eSpark-Backup/manarharake-palmpcb/Design_Files/Renderings/3D_Isometric.PNG

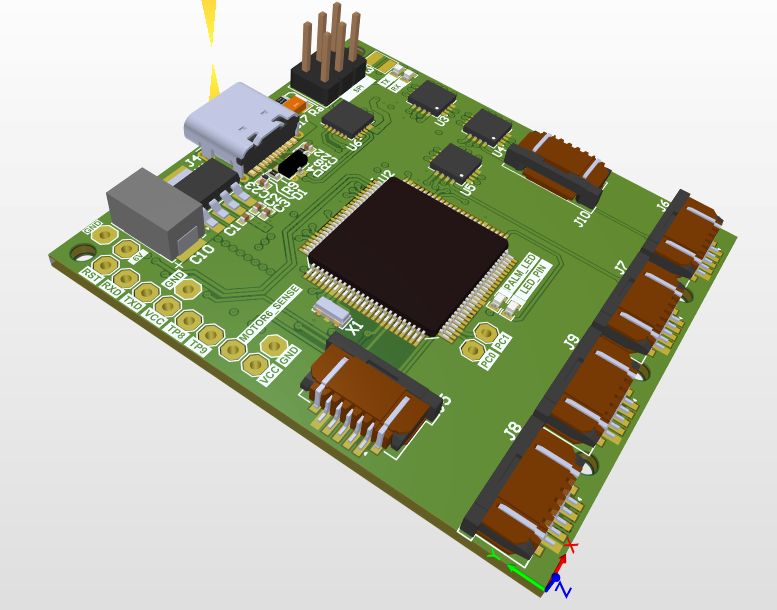
Design_Files/Renderings/3D_Isometric.PNG
