eSpark-Backup/manarharake-palmpcb/Design_Files/Renderings/3D_Top.PNG

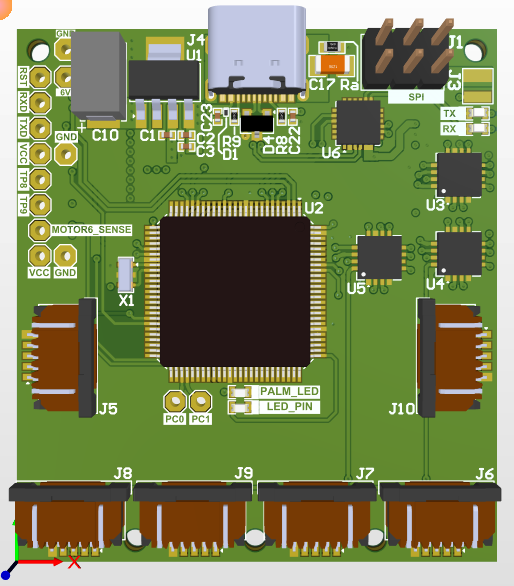
Design_Files/Renderings/3D_Top.PNG
