eSpark-Backup/manarharake-palmpcb/Design_Files/Renderings/2D_Bottom_Layer.PNG

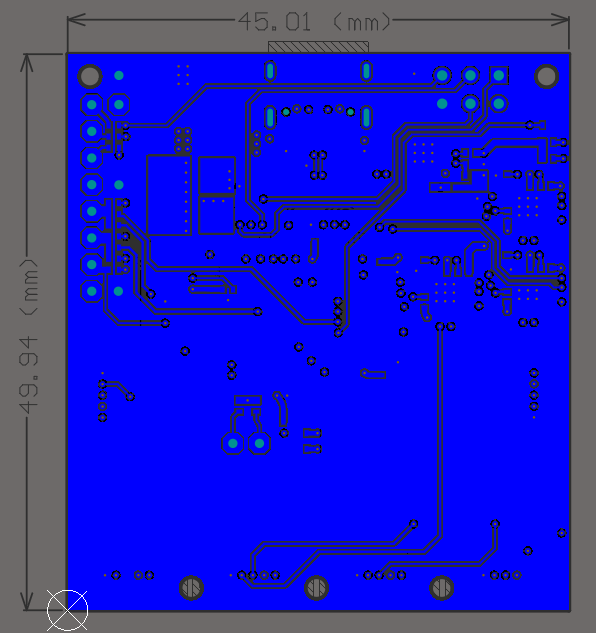
Design_Files/Renderings/2D_Bottom_Layer.PNG
