eSpark-Backup/manarharake-palmpcb/Design_Files/Renderings/2D_Signal_1_Layer.PNG

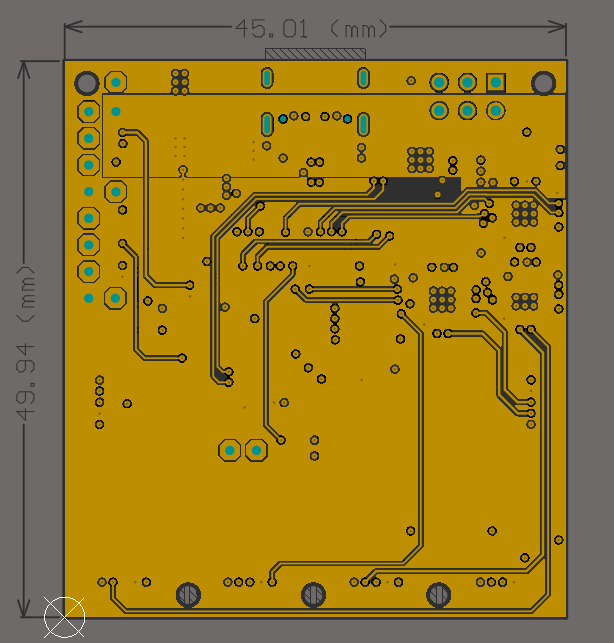
Design_Files/Renderings/2D_Signal_1_Layer.PNG
