eSpark-Backup/manarharake-palmpcb/Design_Files/Renderings/2D_Signal_2_Layer.PNG

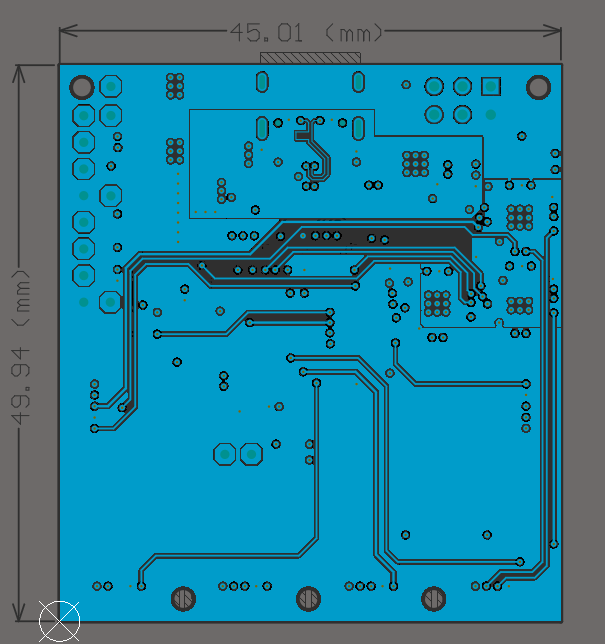
Design_Files/Renderings/2D_Signal_2_Layer.PNG
