eSpark-Backup/manarharake-palmpcb/Design_Files/Renderings/2D_Top.PNG

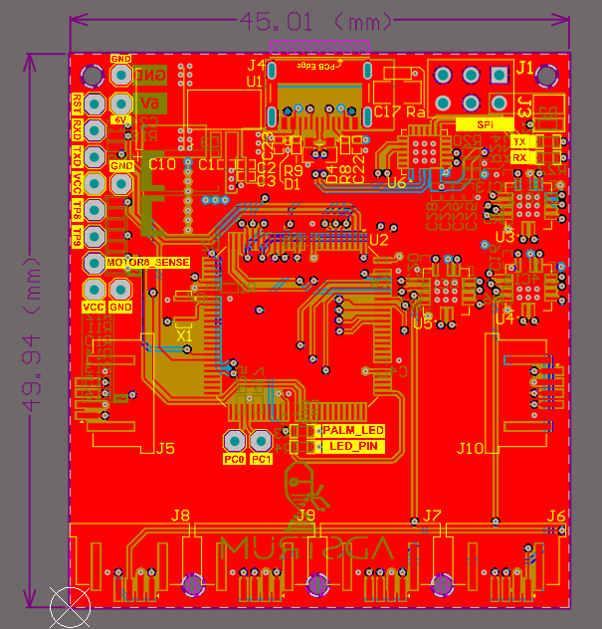
Design_Files/Renderings/2D_Top.PNG
