eSpark-Backup/manarharake-palmpcb/Design_Files/Renderings/3D_Bottom.PNG

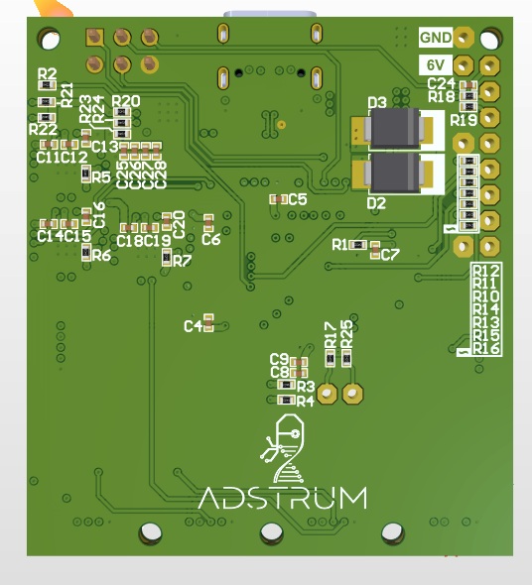
Design_Files/Renderings/3D_Bottom.PNG
