eSpark-Backup/manarharake-palmpcb/docs/Client-Files/palm1/PCB2/PCB files/Bottom.png

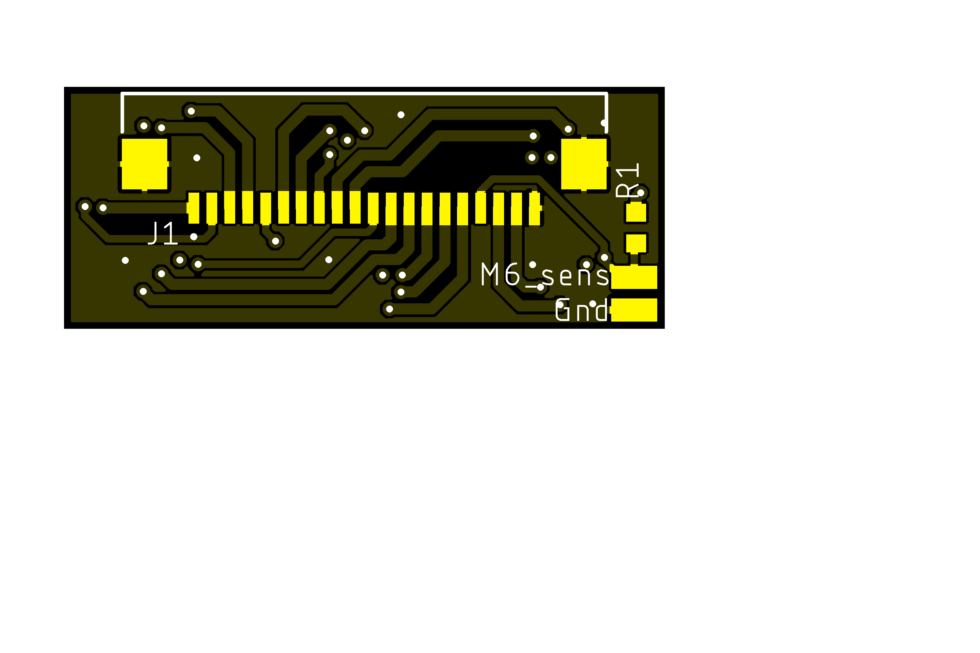
docs/Client-Files/palm1/PCB2/PCB files/Bottom.png
