eSpark-Backup/manarharake-palmpcb/docs/Client-Files/palm1/PCB 1/PCB files/BOTTOM.png

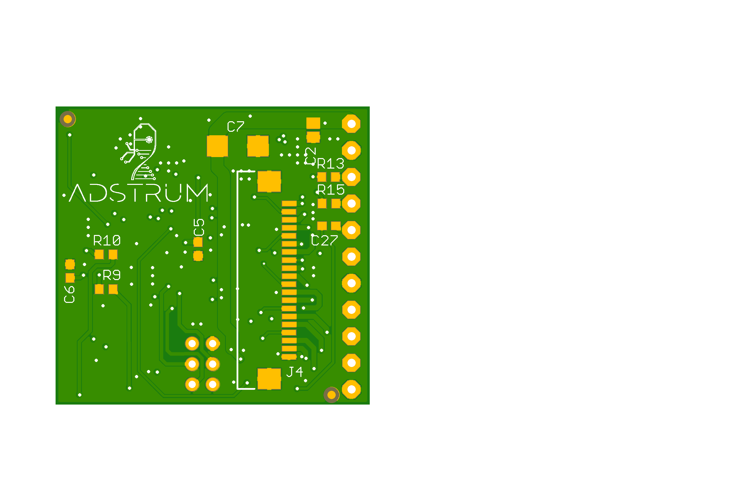
docs/Client-Files/palm1/PCB 1/PCB files/BOTTOM.png
