eSpark-Backup/manarharake-palmpcb/Design_Files/BOM/Client_BOM.xlsx

# | Item Type | Designator | Description | Footprint | Manufacturer Part Number | Manufacturer | Value | Quantity | Remarks
1 | Capacitor | C1, C3 | CAP CER 1UF 10V X5R 0402 | Cap-0402 | CC0402KRX5R6BB105 | Yageo | 1uF | 2
2 | Capacitor | C2 | CAP CER 10UF 10V X5R 0402 | Cap-0402 | CC0402MRX5R6BB106 | Yageo | 10uF | 1
3 | Capacitor | C4, C5, C6, C7, C8, C9, C12, C15, C19, C24, C25, C27 | CAP CER 0.1UF 25V X5R 0402 | Cap-0402 | CC0402KRX5R8BB104 | Yageo | 100nF | 12
4 | Capacitor | C10 | 47uF 25V 0.9Ω@100kHz ±10% CASE-D-7343 Tantalum Capacitors ROHS | Case-D | CA45-D025K476T | Hunan Xiangyee in S&T | 47uF | 1
5 | Capacitor | C11, C14, C18 | CAP CER 10000PF 50V X7R 0402 | Cap-0402 | CC0402KRX7R9BB103 | Yageo | 10nF | 3
6 | Capacitor | C13, C16, C20 | CAP CER 2.2UF 25V X5R 0402 | Cap-0402 | GRM155R61E225KE11D | Murata | 2.2uf | 3
7 | Capacitor | C17 | CAP CER 4700PF 1KV X7R 1206 | Cap-1206 | CC1206KKX7RCBB472 | Yageo | 4.7nF | 1
8 | Capacitor | C22, C23 | CAP CER 10000PF 25V X7R 0402 | Cap-0402 | CC0402KRX7R8BB103 | Yageo | 10nF | 2
9 | Capacitor | C26, C28 | CAP CER 4.7UF 10V X5R 0402 | Cap-0402 | CC0402KRX5R6BB475 | Yageo | 4.7uF | 2
10 | Diode | D1 | TVS DIODE 5VWM 6.3VC DSN0603-2 | DSN0603-2 | PESD5V0H1BSFYL | Nexperia | - | 1
11 | Diode | D2, D3 | 40V 5A 550mV@5A DO-214AA(SMB) Schottky Barrier Diodes (SBD) ROHS | SMB | SS54B-HF | Comchip (https://www.lcsc.com/brand-detail/11578.html) | - | 2
12 | Diode | D4 | 16A 20V 7V 5V@Max Unidirectional SOT-23 TVS ROHS | Sot-23 | ESD5302F-3/TR | WILLSEMI | - | 1
13 | Male Header | J1 | 3A Straight Square Pins 2.5mm 6P 6mm -40℃~+105℃ 3mm 2.54mm 双排 Black 2x3P 2.54mm Plugin,P=2.54mm Pin Headers ROHS | Custom | PH-01291 | Liansheng | - | 1
14 | SMD PAD | J3 | 2mm pitch Solder Pad | Custom | - | - | - | 1
15 | USB C Connector | J4 | 5A 1 16P Female Type-C SMD USB Connectors ROHS | Custom | TYPE-C-31-M-12 | Korean Hroparts Elec | - | 1
16 | FPC Connector | J5, J6, J7, J8, J9, J10 | CONN FFC FPC BOTTOM 5POS 1MM R/A | Custom | SFW5R-1STE1LF | Amphenol ICC / FCI (https://www.lcsc.com/brand-detail/86.html) | - | 6
17 | LED | LED1, LED2 | blue 0603 Light Emitting Diodes (LED) ROHS | LED-0603 | NCD0603B3 | Foshan NationStar Optoelectronics | - | 2
18 | LED | LED3, LED4 | yellow 0603 Light Emitting Diodes (LED) ROHS | LED-0603 | NCD0603Y2 | Foshan NationStar Optoelectronics | - | 2
19 | Resistor | R1, R5, R6, R7, R11, R13, R16 | RES 10K OHM 1% 1/16W 0402 | Res-0402 | RC0402FR-0710KL | Yageo | 10K | 7
20 | Resistor | R2 | RES 3.3K OHM 1% 1/16W 0402 | Res-0402 | RC0402FR-073K3L | Yageo | 3.3K | 1
21 | Resistor | R3, R4, R18, R19 | RES 1K OHM 5% 1/16W 0402 | Res-0402 | RC0402JR-071KL | Yageo | 1K | 4
22 | Resistor | R8, R9 | RES 5.1K OHM 1% 1/16W 0402 | Res-0402 | RC0402FR-075K1L | Yageo | 5.1K | 2
23 | Resistor | R10, R15 | RES 10K OHM 1% 1/16W 0402 | Res-0402 | RC0402FR-0710KL | Yageo | DNF | 2
24 | Resistors | R12, R14 | RES 0 OHM JUMPER 1/16W 0402 | Res-0402 | RC0402FR-070RL | Yageo | 0R | 2
25 | Resistor | R20 | RES 1.2K OHM 1% 1/16W 0402 | Res-0402 | RC0402FR-071K2L | Yageo | 1.2K | 1
26 | Resistor | R21, R22 | RES 470 OHM 1% 1/16W 0402 | Res-0402 | RC0402FR-07470RL | Yageo | 470R | 2
27 | Resistor | R23 | RES SMD 22.1KOHM 0.1% 1/16W 0402 | Res-0402 | RT0402BRD0722K1L | Yageo | 22.1K | 1
28 | Resistor | R24 | 62.5mW Thick Film Resistors 50V ±100ppm/℃ ±1% 47.5kΩ 0402 Chip Resistor - Surface Mount ROHS | Res-0402 | 0402WGF4752TCE | Uniroyal | 47.5K | 1
29 | Resistor | Ra | RES SMD 1M OHM 1% 1/10W 0603 | Res-0603 | RC0603FR-071ML | Yageo | 1M | 1
30 | IC | U1 | IC REG LINEAR 5V 1A SOT223-5 | SOT-223-5 | LP38692MP-5.0/NOPB | Texas Instruments | - | 1
31 | IC | U2 | IC MCU 8BIT 256KB FLASH 100TQFP | TQFP-100(14x14) | ATMEGA2560-16AU | Microchip | - | 1
32 | IC | U3, U4, U5 | IC MOTOR DRIVER PAR 16QFN | QFN-16-EP(4x4) | DRV8833RTYR | Texas Instruments | - | 3
33 | IC | U6 | IC USB TO UART BRIDGE QFN24 | 24-QFN (4x4) | CP2102N-A02-GQFN24R | Silicon Labs | - | 1
34 | Crystal | X1 | CERAMIC RES 16.0000MHZ 15PF SMD | SMD3213-3P | CSTNE16M0VH3C000R0 | Murata | - | 1
