eSpark-Backup/manarharake-palmpcb/docs/Client-Files/palm1/PCB 1/Manufacturing Files/BOM.xlsx

Starfish PCB BOM |  | Created By: Dharmik Patel https://www.upwork.com/o/profiles/users/~01178b3bf7c1a90506/
Qty | Value | Part no | Make | Package | Parts | Description
1 | 100nF - 50V | CC1210KKX7R9BB104 | Yageo | C1210 | C1 | CAPACITOR
9 | 100nF - 50V | CC0603KRX7R9BB104 | Yageo | C0603 | C3, C5, C6, C8, C10, C14, C17, C20, C27 | CAPACITOR
3 | 10nF - 50V | CL10B103KB8WPJC | Samsung Electro-Mechanics | C0603 | C16, C19, C22 | CAPACITOR
1 | 10uF | GRM21BR61H106KE43L | Murata Electronics | C0805 | C2 | CAPACITOR
2 | 1uF | CC0805KKX7R9BB105 | Yageo | C0805 | C4, C9 | CAPACITOR
3 | 2.2uF | GRM188R61H225KE11D | Murata Electronics | C0603 | C15, C18, C21 | CAPACITOR
1 | 47u/16V Tantlum | TAJC476K016RNJ (https://www.digikey.in/en/products/detail/kyocera-avx/TAJC476K016RNJ/563823) | AVX | C/6032-28R | C7 | POLARIZED CAPACITOR
4 | 1K | RC0603FR-071KL | Yageo | R0603 | R13, R14, R15, R17 | RESISTOR
1 | 3k3 | M55342K12B3E30MTSV-ND |  | R0603 | R1 | RESISTOR
2 | DNF | R-EU_R0603 |  | R0603 | R9, R10 | RESISTOR
2 | 0R | R-EU_R0603 |  | R0603 | R8, R12 | RESISTOR
6 | 10K | RC0603FR-0710KL | Yageo | R0603 | R3, R4, R5, R6, R7, R11 | RESISTOR
1 | ATMEGA2560-16AU | ATMEGA2560-16AU |  | TQFP100 | IC1 | MICROCONTROLLER
1 | CSTNE16M0VH3C000R0 | CSTNE16M0VH3C000R0 (https://www.digikey.in/en/products/detail/murata-electronics/CSTNE16M0VH3C000R0/8747732) |  | OSC_CSTNE16M0VH3C000R0 | Y1 | 16MHz Ceramic Resonator Built in Capacitor 15pF Â±0.15% 40 Ohms
1 | DNF | AVRISP-6 |  | AVRISP | J3 | AVR ISP HEADER
3 | DRV8833RTYT | DRV8833RTYT |  | QFN65P400X400X80-17N | U2, U3, U4 | DUAL H-BRIDGE MOTOR DRIVER,QFN-16
1 | FFC3B07-20-T | FFC3B07-20-T (https://www.digikey.in/en/products/detail/gct/FFC3B07-20-T/10657038) |  | GCT_FFC3B07-20-T | J4 | FPC 1.0mm Pitch, Side entry, Top contact, SMT, Height 2.5mm, Slide type
1 | LP38692MP-5.0 | LP38692MP-5.0 (https://www.digikey.in/en/products/detail/texas-instruments/LP38692MP-5-0-NOPB/723329) |  | SOT150P696X180-5N | U7 | Linear Regulator Check availability
