eSpark-Backup/manarharake-palmpcb/docs/Client-Files/palm1/PCB2/Manufacturing File/BOM.xlsx

Starfish PCB2 BOM |  | Created By: Dharmik Patel https://www.upwork.com/o/profiles/users/~01178b3bf7c1a90506/
Qty | Value | Part no | Make | Package | Parts | Description
1 | 10K | RC0603FR-0710KL | Yageo | R0603 | R1 | RESISTOR, European symbol
1 | FFC3B07-20-T | FFC3B07-20-T (https://gct.co/connector/ffc3b07) | GCT | SMD | J1 | FPC 1.0mm Pitch, Side entry, Top contact, SMT, Height 2.5mm, Slide type
6 | SFW5R-1STE1LF | SFW5R-1STE1LF | FCI_SFW5R-1STE1LF | SMD | M1, M2, M3, M4, M5, M6 | FFC/FPC CONNECTOR, RECEPTACLE, 5POS 1ROW
