eSpark-Backup/manarharake-palmpcb/Design_Files/Supporting Files/PCB_Palm_v2.0.step

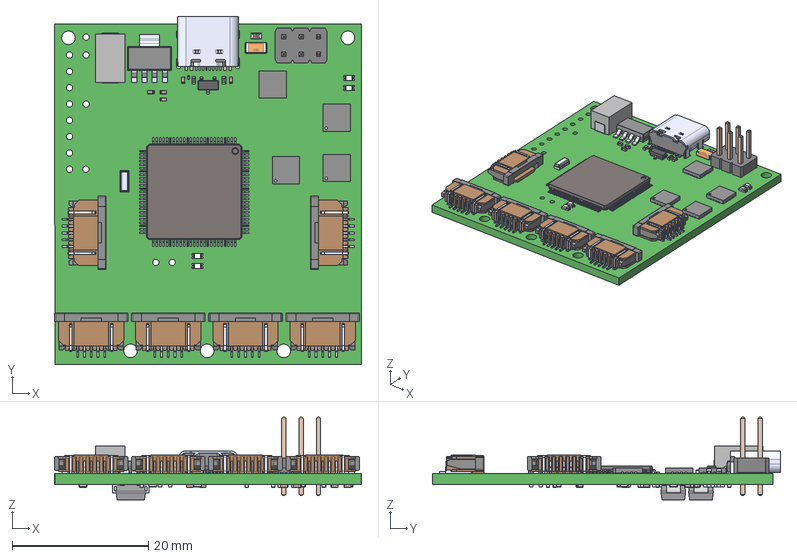
[picture p13: CAD file, 2024-06-21]
Design_Files/Supporting Files/PCB_Palm_v2.0.step
45.1 x 51.1 x 12.2 mm
User_Library-RES_1005-0402 x 25
User_Library-Capacitor_0402 x 25
SFW8R-1STE1LF_SFW5R-1STE1LF x 6
TYPE-C-31-M-12
User_Library-LED_SMD0603 x 4
CP2102N-A02-GQFN24R--3DModel-STEP-56544
CircuitWorks-SOT-23
User_Library-DO-214AA_SMB x 2
CSTCE16M0V53-R0
DRV8833RTYR x 3
TQFP_100
LP38692MP-5.0
User_Library-RESC1608X05N
6130xx21121_PIN x 6
PESD5V0H1BSF
User_Library-1206_SMD_Capacitor
