eSpark-Backup/manarharake-palmpcb/docs/Client-Files/palm1/PCB2/3D file/Motor Connection V1.stp

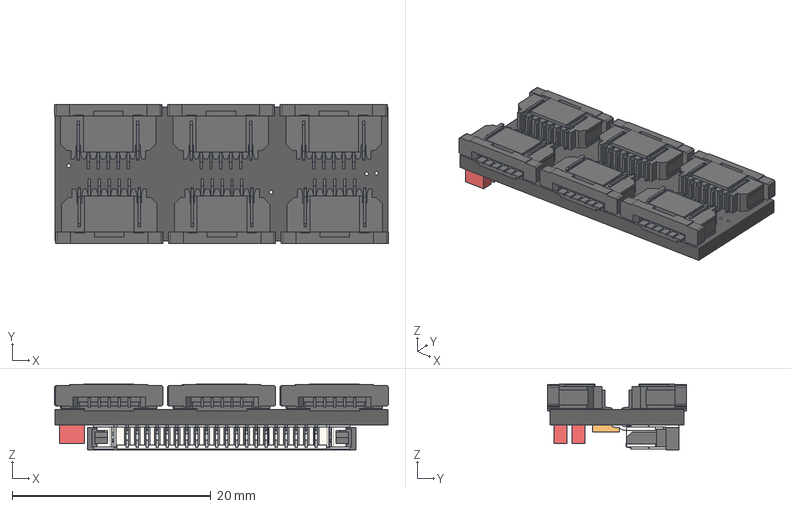
[picture p14: CAD file, 2024-06-12]
docs/Client-Files/palm1/PCB2/3D file/Motor Connection V1.stp
33.6 x 14.0 x 6.62 mm
Board
SFW5R-1STE1LF x 6
_FFC3B07-20_H1
_FFC3B07-20_H2
_FFC3B07_SC x 2
_FFC3B07-T_P x 20
R0603
SMD1,27-2,54 x 2
