eSpark-Backup/manarharake-palmpcb/docs/Client-Files/pcb-reference-files/PCB Layout Top.DXF

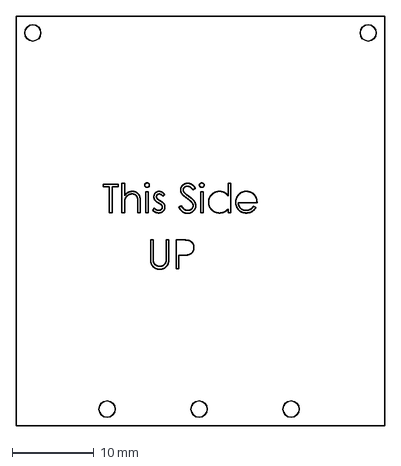
[picture p15: CAD file, 2024-06-20]
docs/Client-Files/pcb-reference-files/PCB Layout Top.DXF
45.0 x 50.0 mm
