eSpark-Backup/manarharake-palmpcb/docs/Client-Files/pcb-reference-files/PCB Layout Bottom.DXF

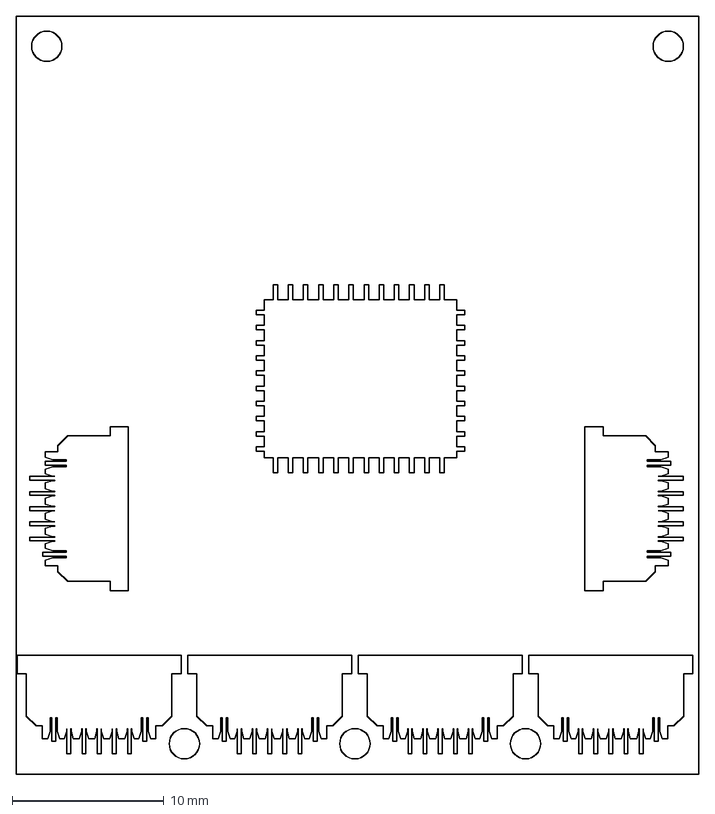
[picture p16: CAD file, 2024-06-20]
docs/Client-Files/pcb-reference-files/PCB Layout Bottom.DXF
45.0 x 50.0 mm
