eSpark-Backup/manarharake-palmpcb/docs/Client-Files/pcb-reference-files/starfish-PCB1.stp

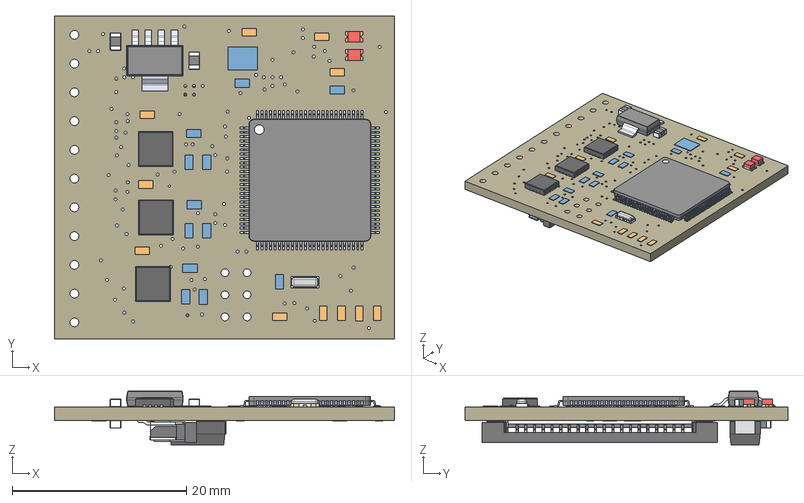
[picture p17: CAD file, 2024-06-12]
docs/Client-Files/pcb-reference-files/starfish-PCB1.stp
39.0 x 37.0 x 6.14 mm
Board
3k3 x 15
100nF
100nF_1 x 15
DRV8833RTYT
DRV8833RTYT_1
DRV8833RTYT_2
ATMEGA2560-16AU
LP38692MP-5.0
Gehäuse x 3
Kontaktfläche x 6
47u/16V Tantlum
_FFC3B07-20_H1
_FFC3B07-20_H2
_FFC3B07_SC x 2
_FFC3B07-T_P x 20
CHIPLED_0805
CHIPLED_0805 (1)
BASE
PIN2
PIN1 AND PIN3 x 2
HAT
gnd x 2
