eSpark-Backup/manarharake-palmpcb/(list of files, cad)

Other CAD files:
Design_Files/Supporting Files/PCB_Palm_v2.0.DWG
Design_Files/Supporting Files/PCB_Palm_v2.0.DXF
