eSpark-Backup/manarharake-palmpcb/Design_Files/Schematics/Schematic_Palm_V2.0.pdf

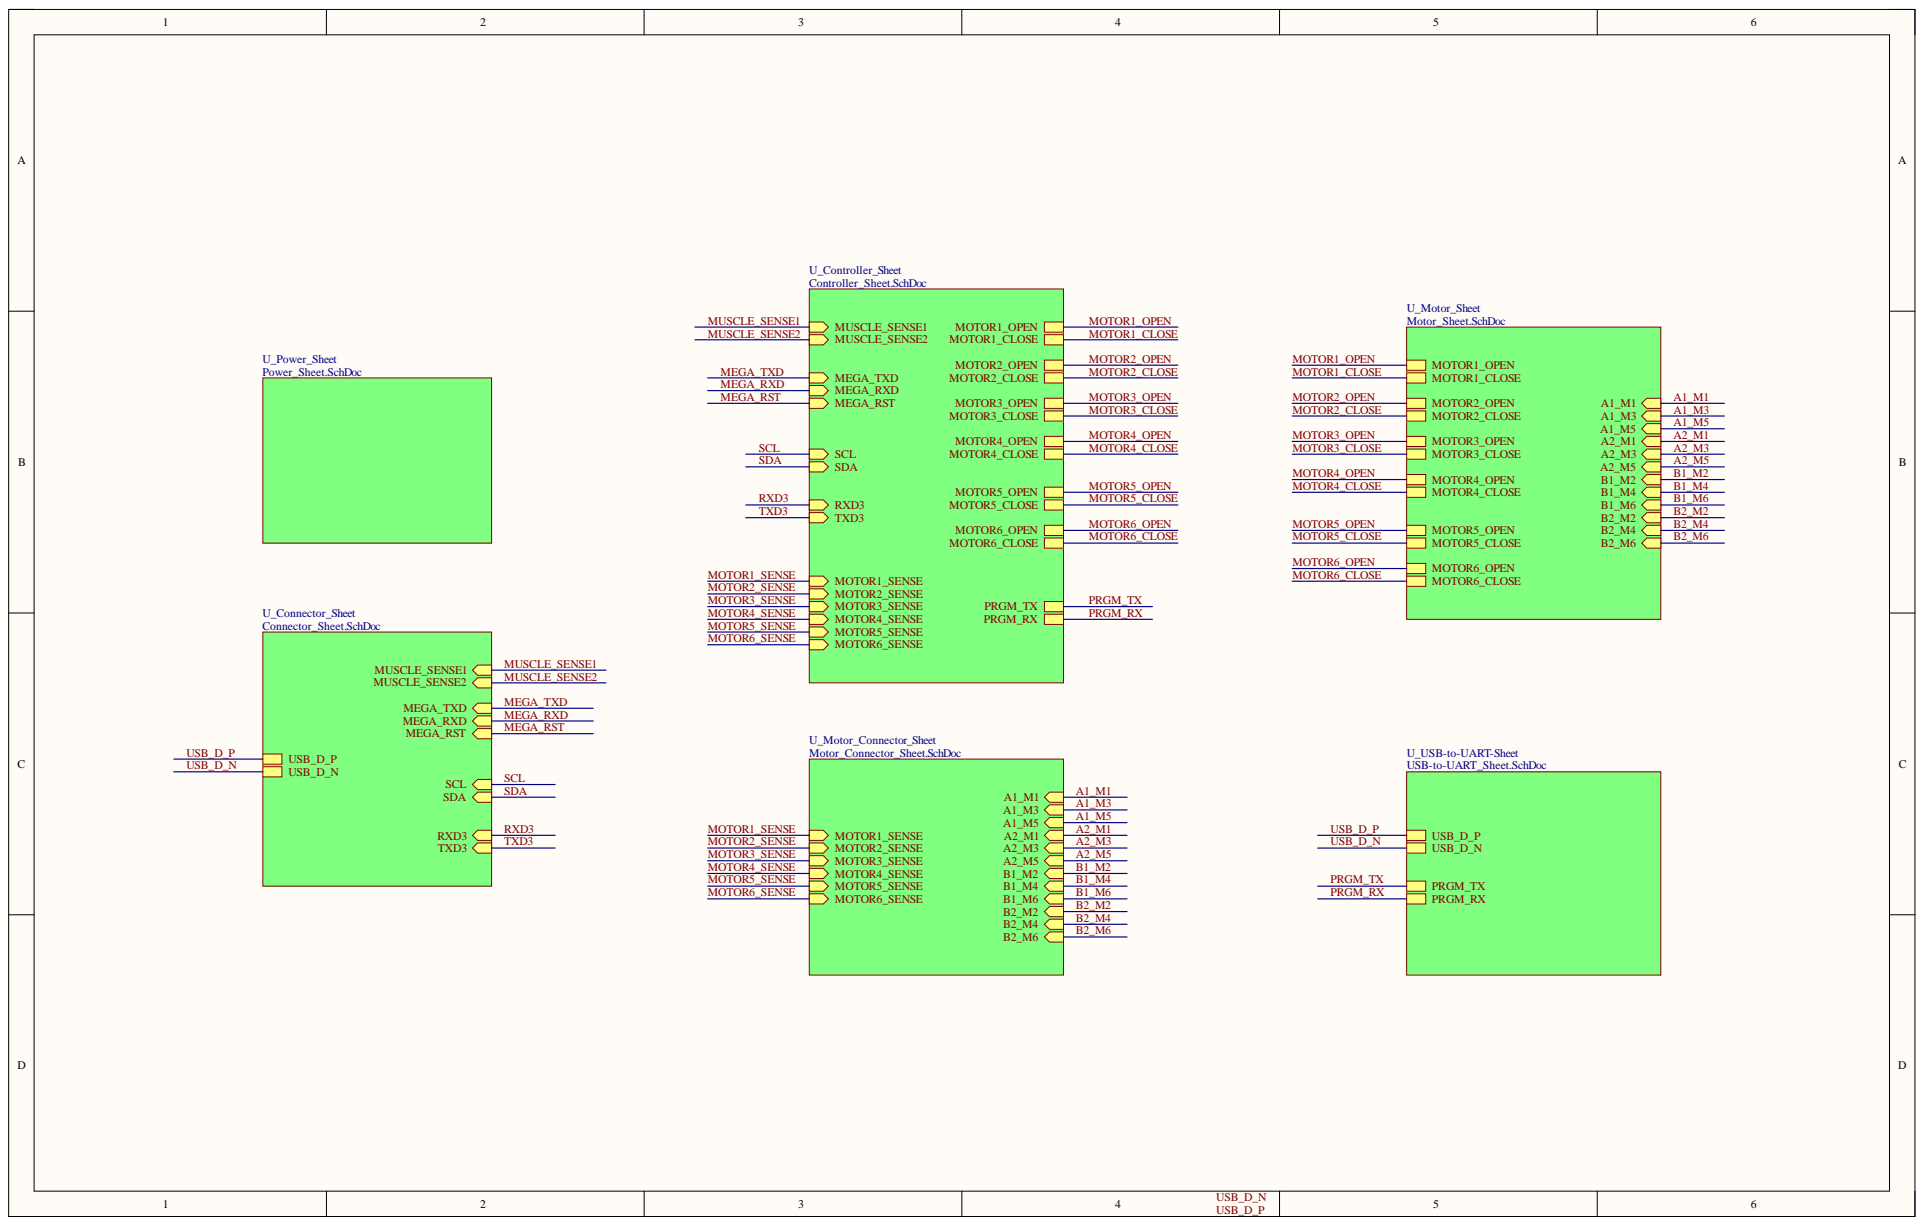
[picture p18: page 1]

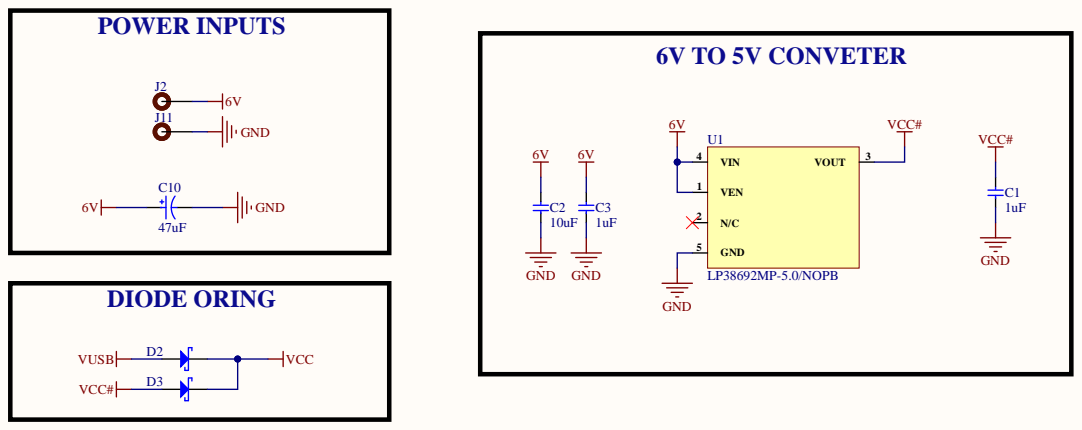
[picture p19: page 2]

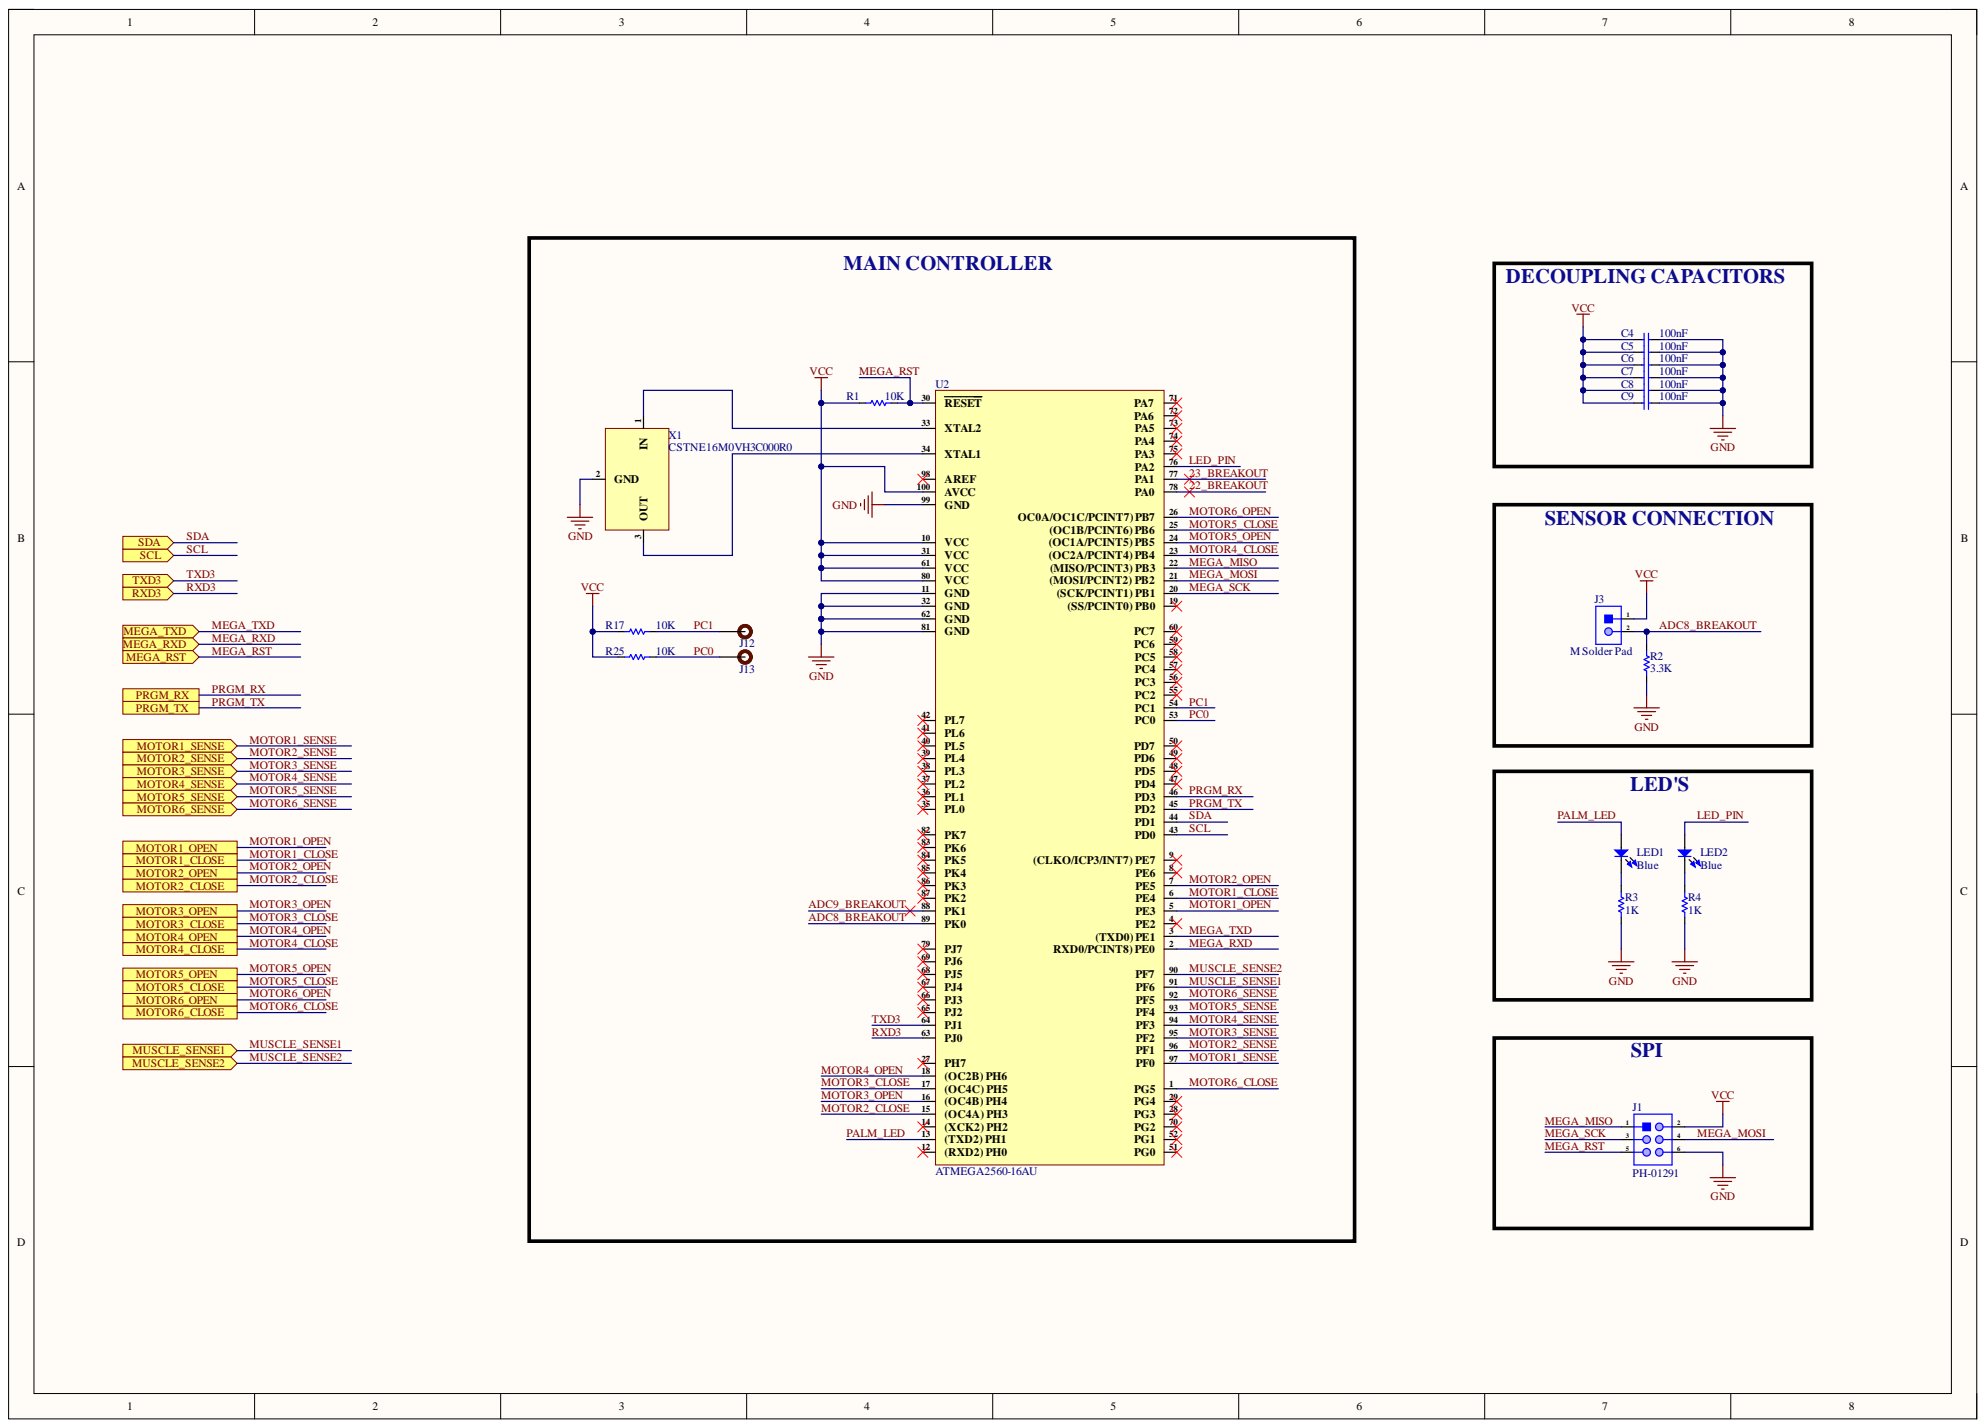
[picture p20: page 3]

C 5 | 1 0 0 n F
C | 6 1 0 0 n F
C 7 | 1 0 0 n F
C 8 | 1 0 0 n F

3 1
6 1
8 0

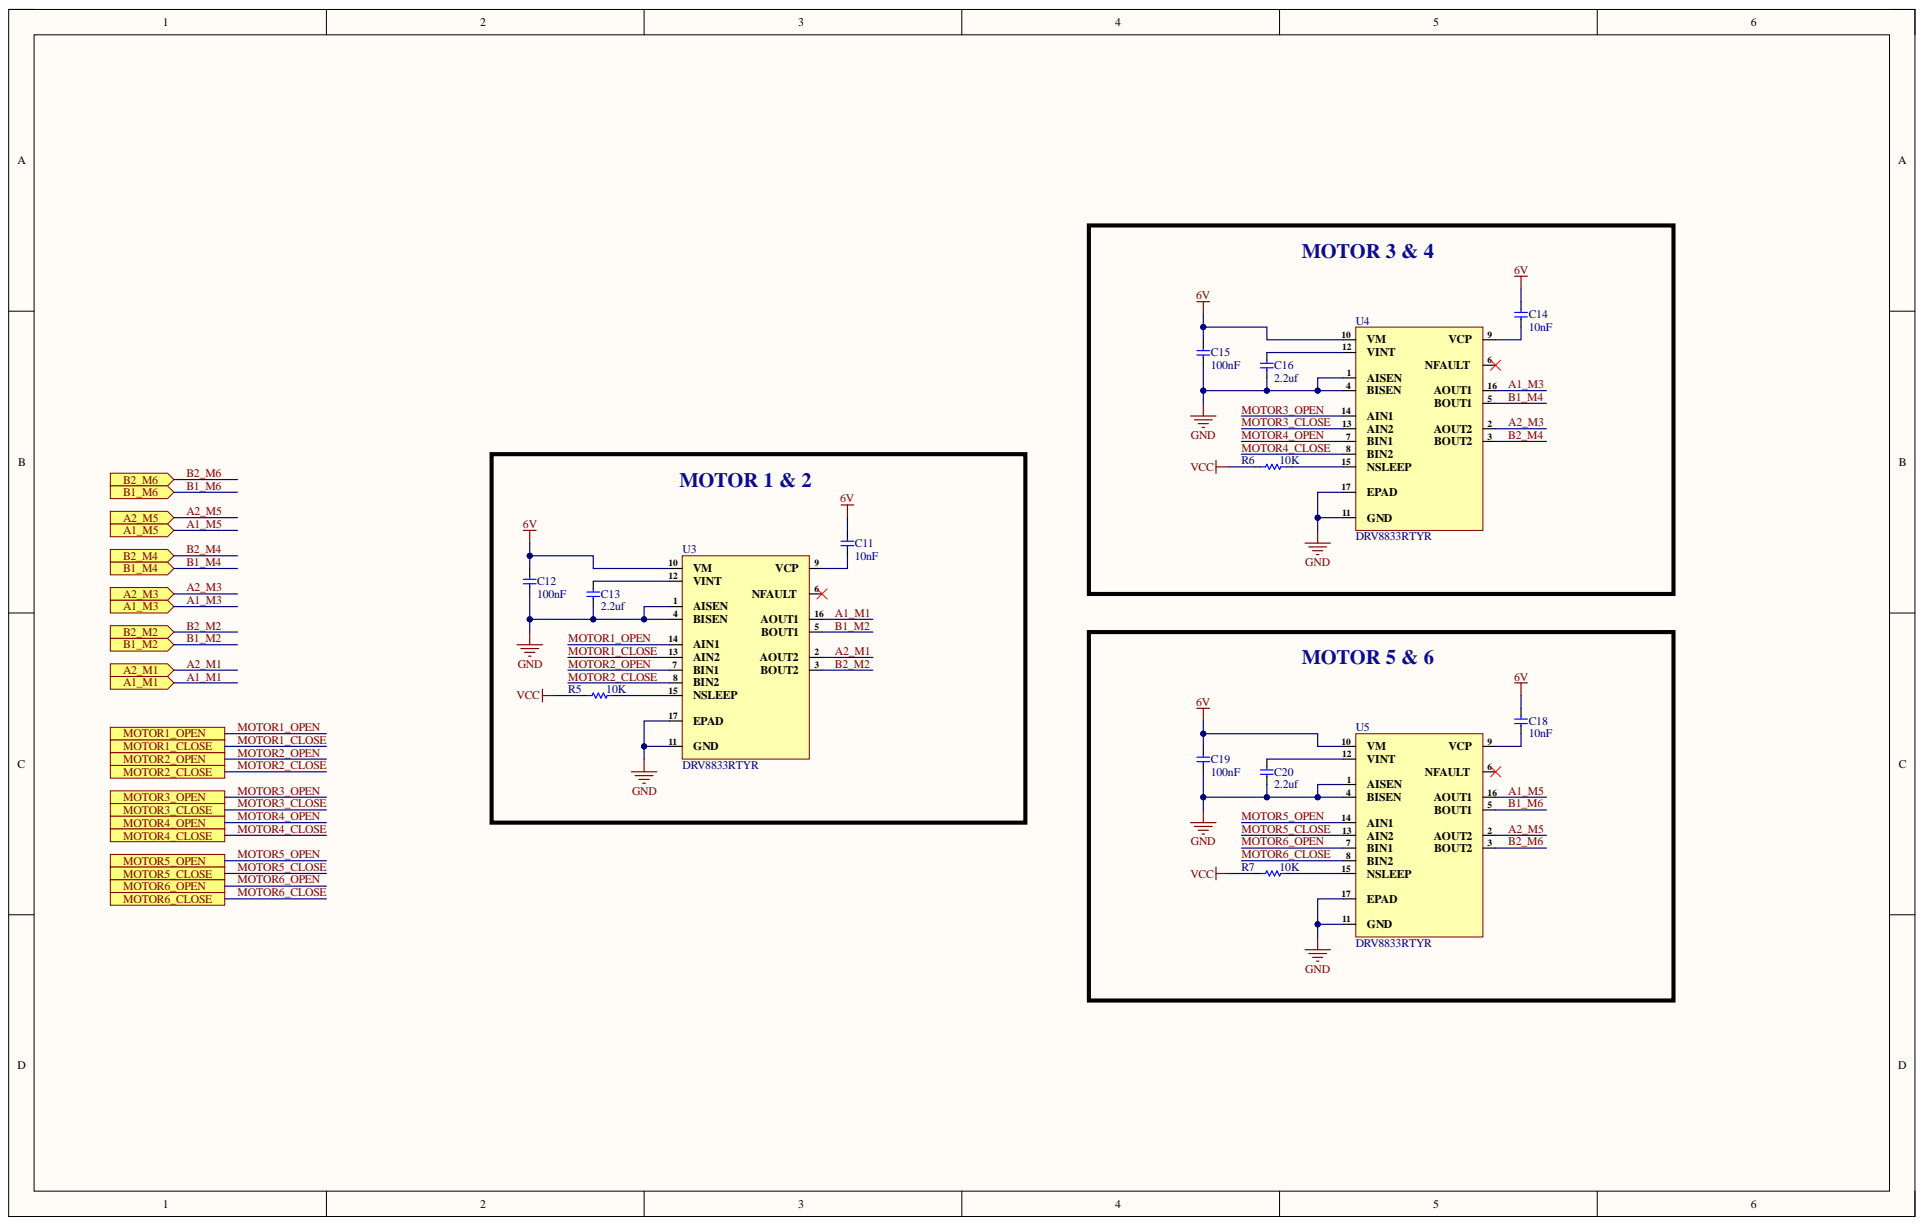
[picture p21: page 4]

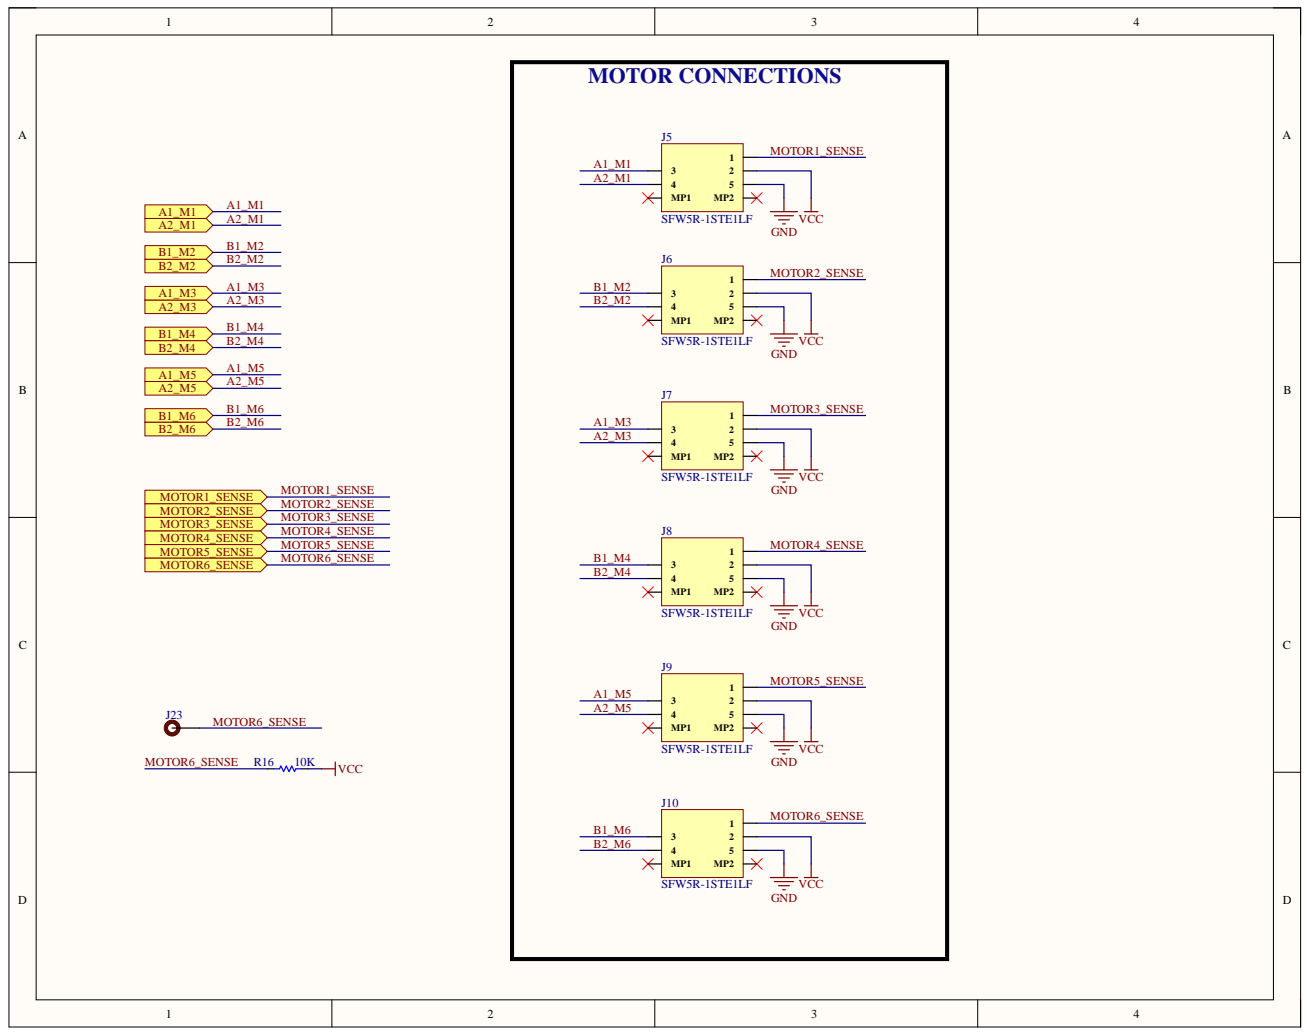
[picture p22: page 5]

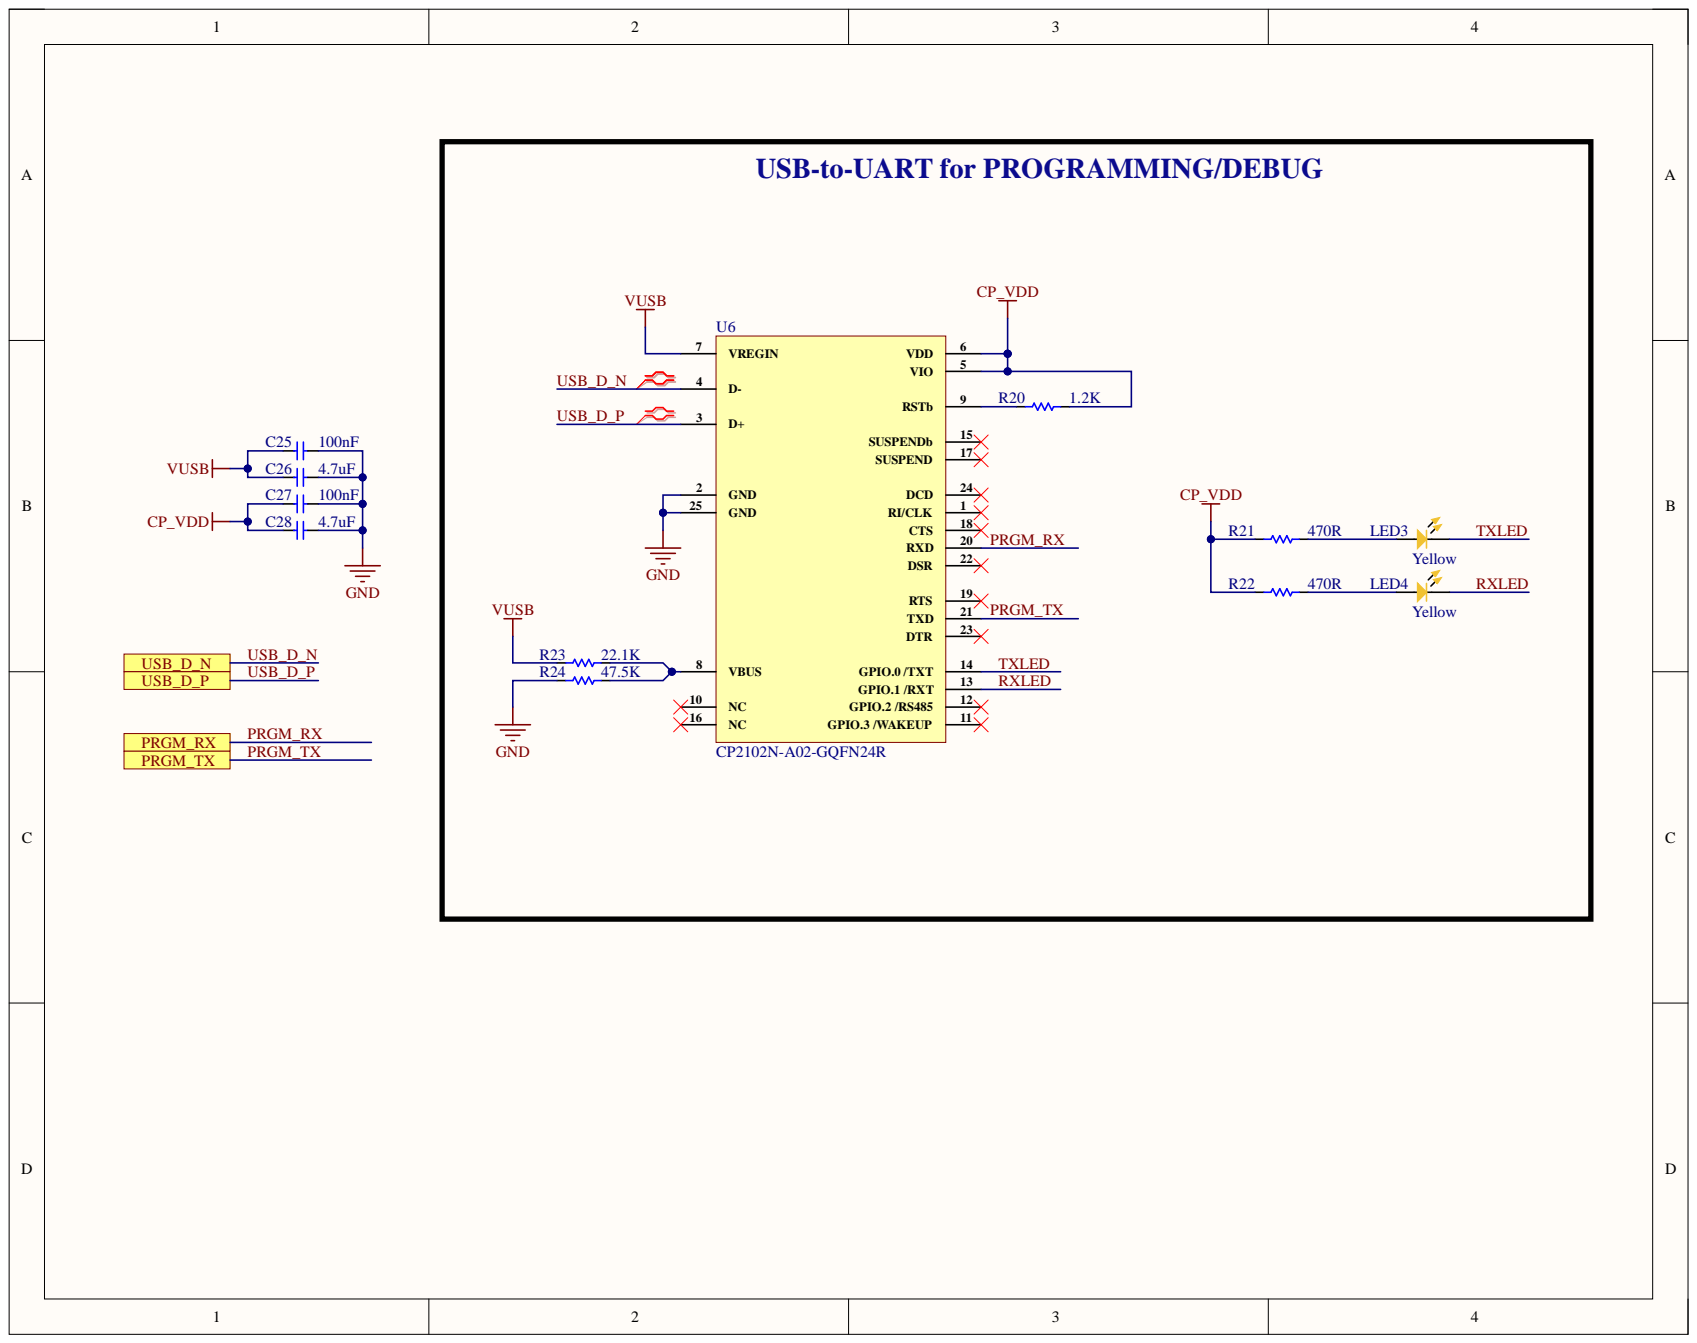
[picture p23: page 6]

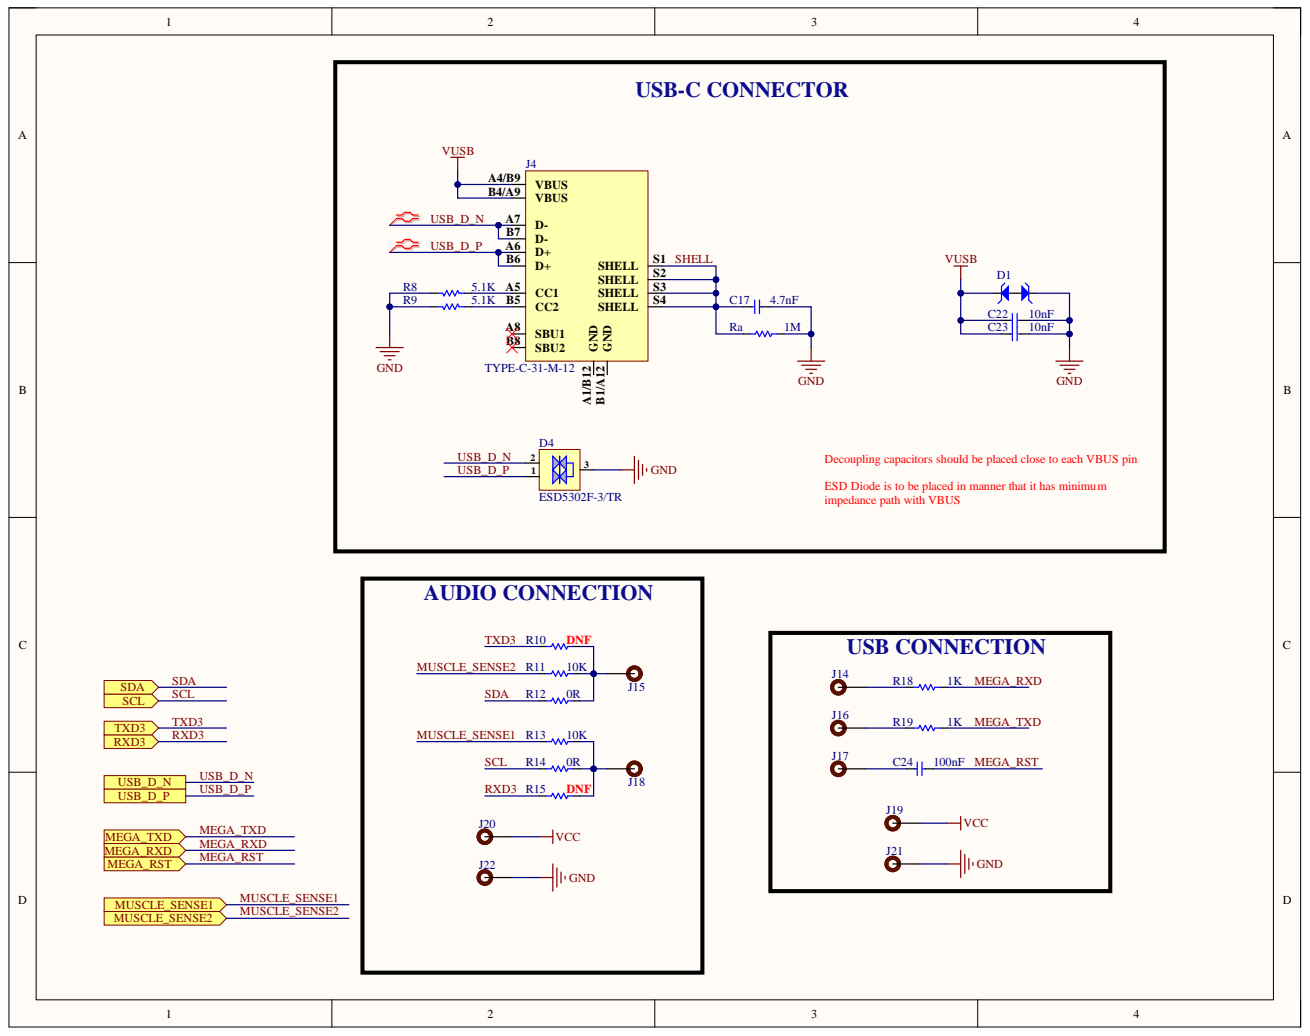
[picture p24: page 7]

Decoupling capacitors should be placed close to each VBUS pin

ESD Diode is to be placed in manner that it has minimum
impedance path with VBUS
