eSpark-Backup/manarharake-palmpcb/Design_Files/Schematics/Assembly_Drawings_V2.0.pdf

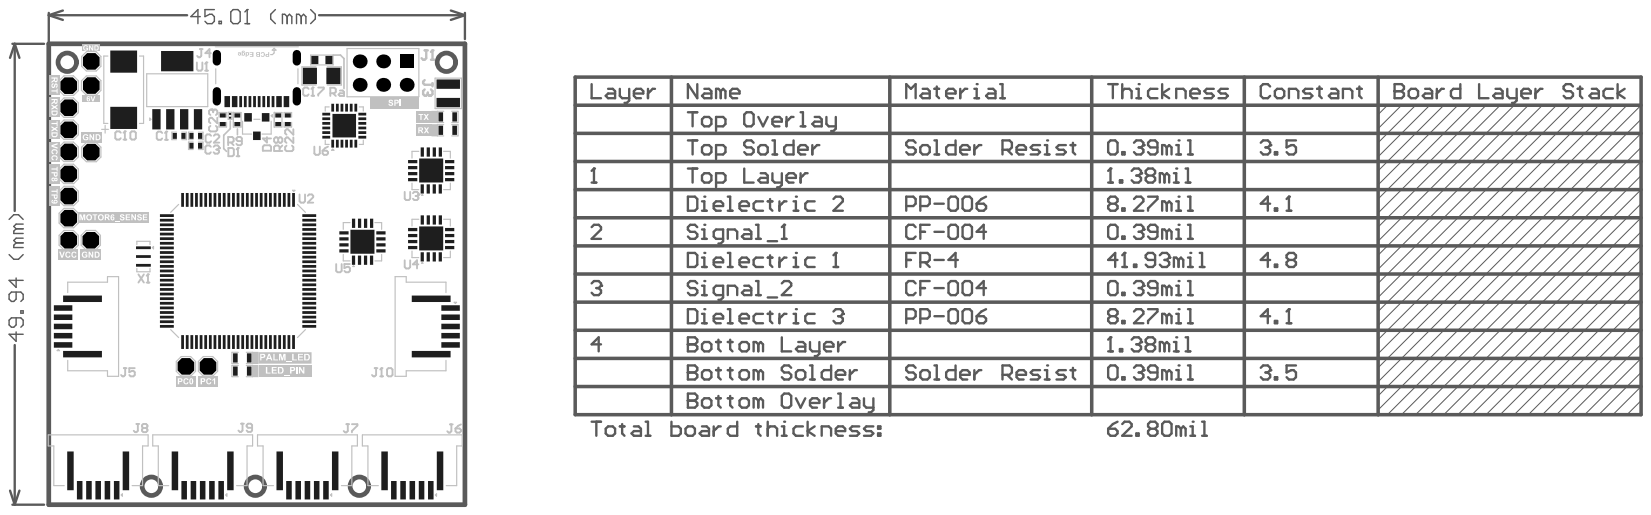
[picture p25: page 1]

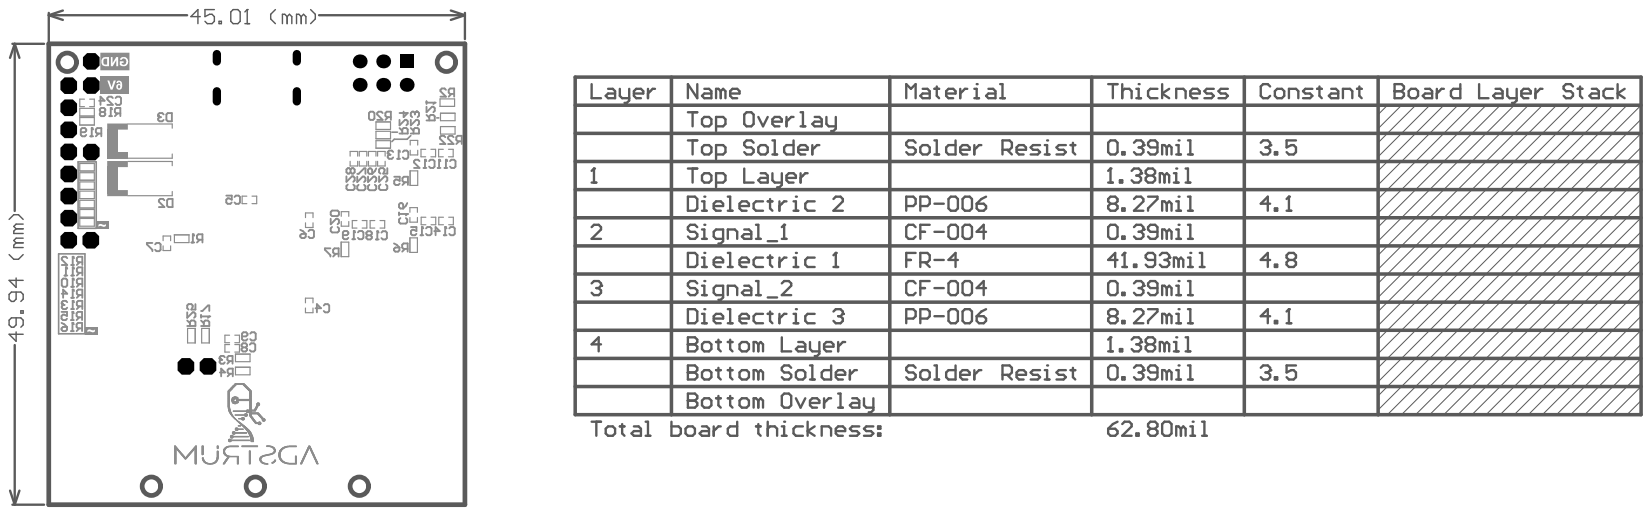
[picture p26: page 2]

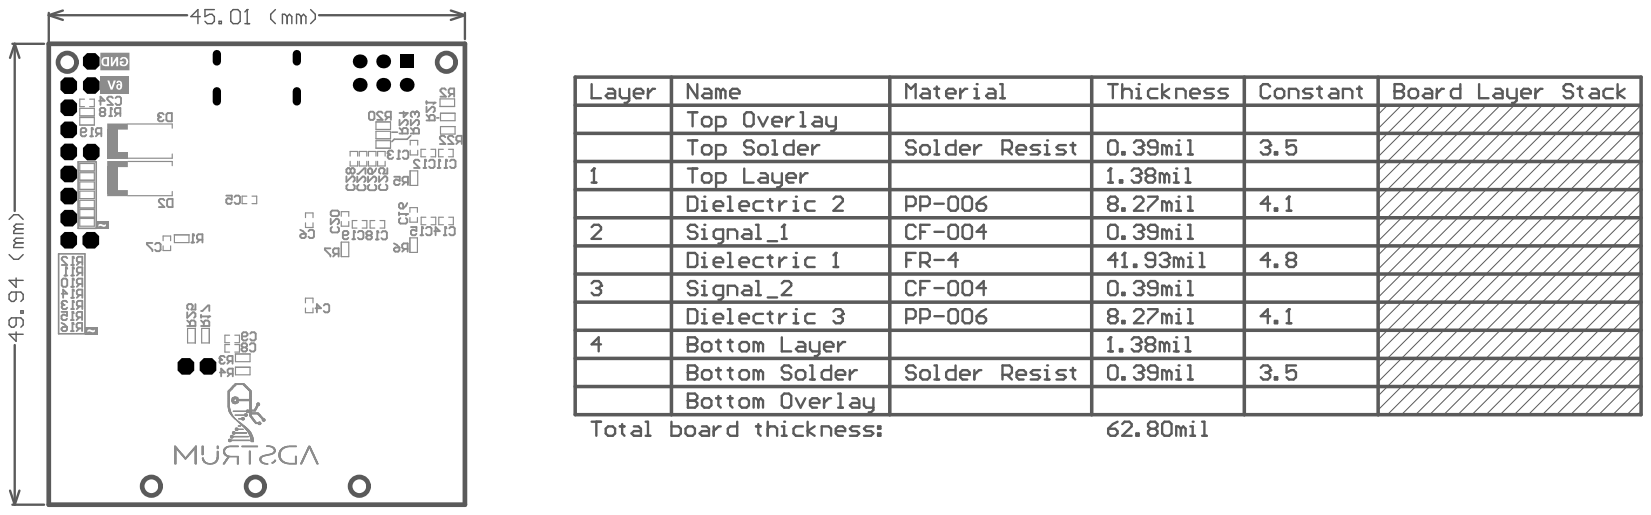
[picture p27: page 3]

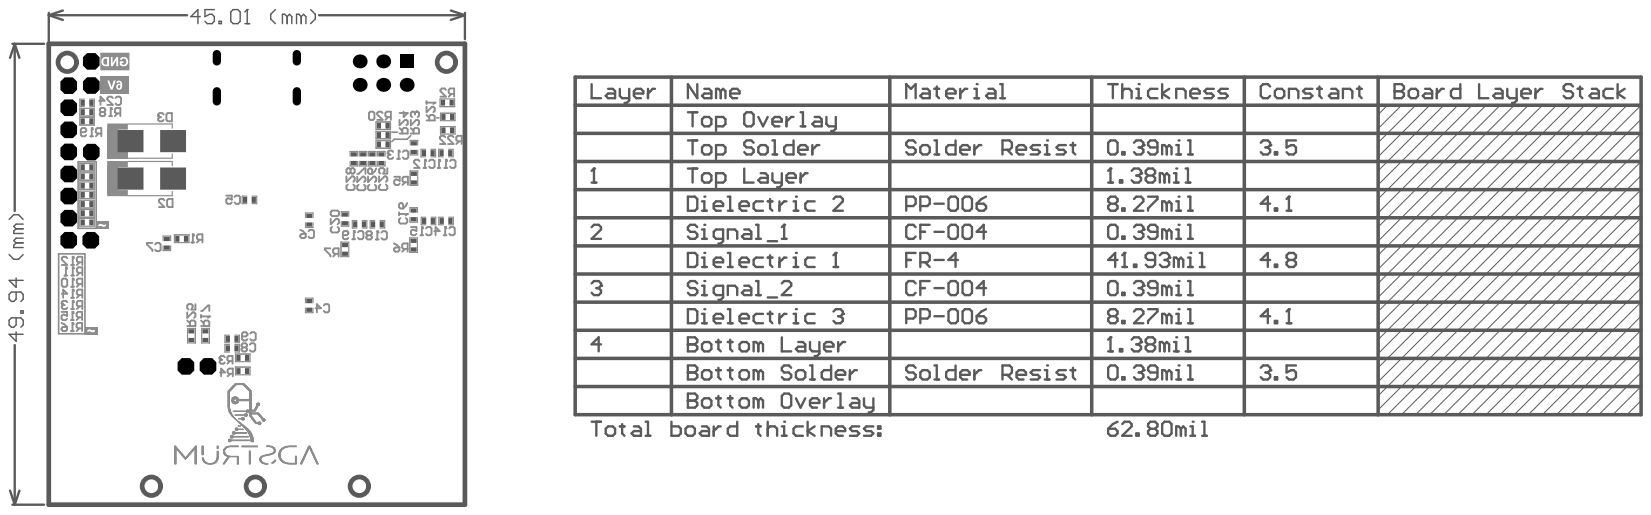
[picture p28: page 4]
