eSpark-Backup/manarharake-palmpcb/docs/Client-Files/palm1/PCB 1/PCB files/starfish_schematic.pdf

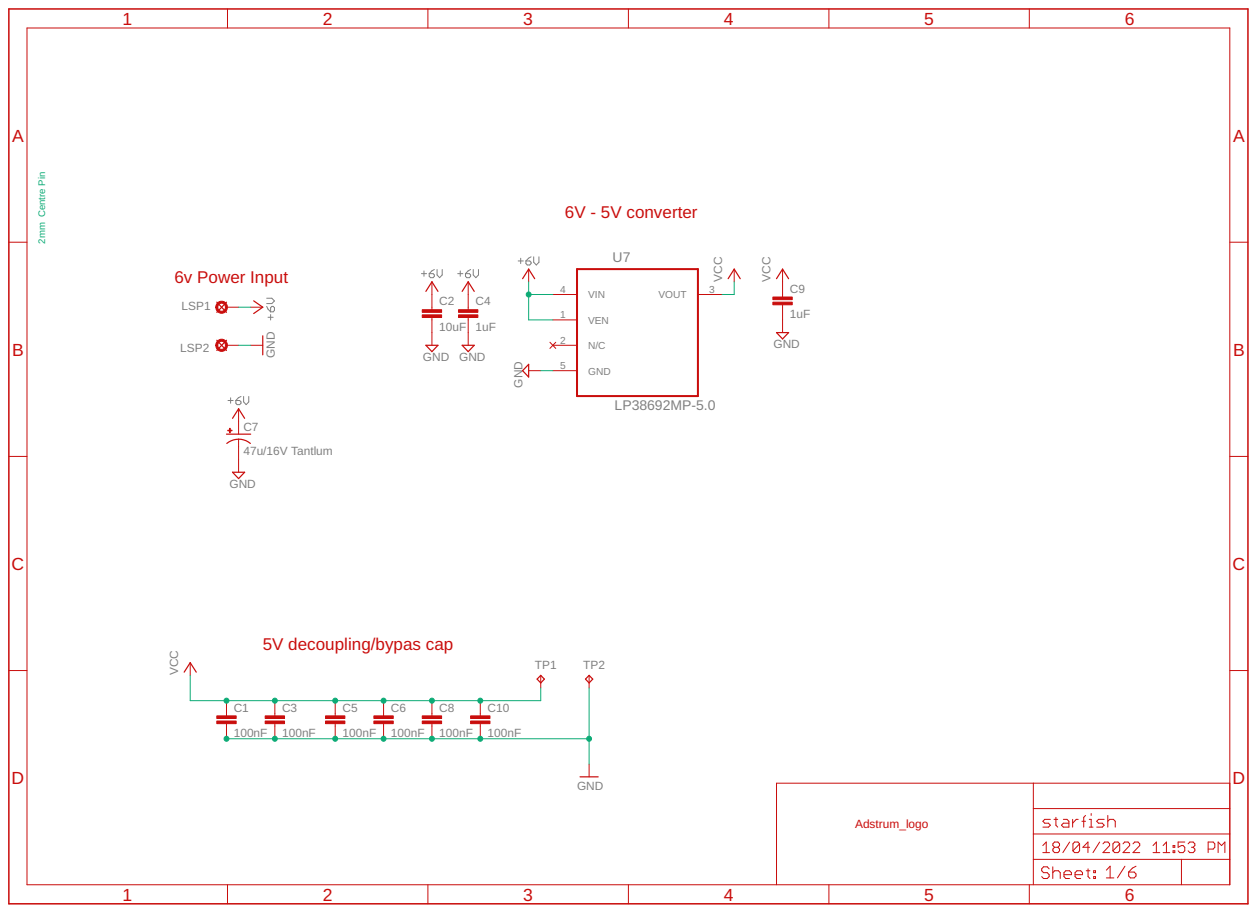
[picture p29: page 1]

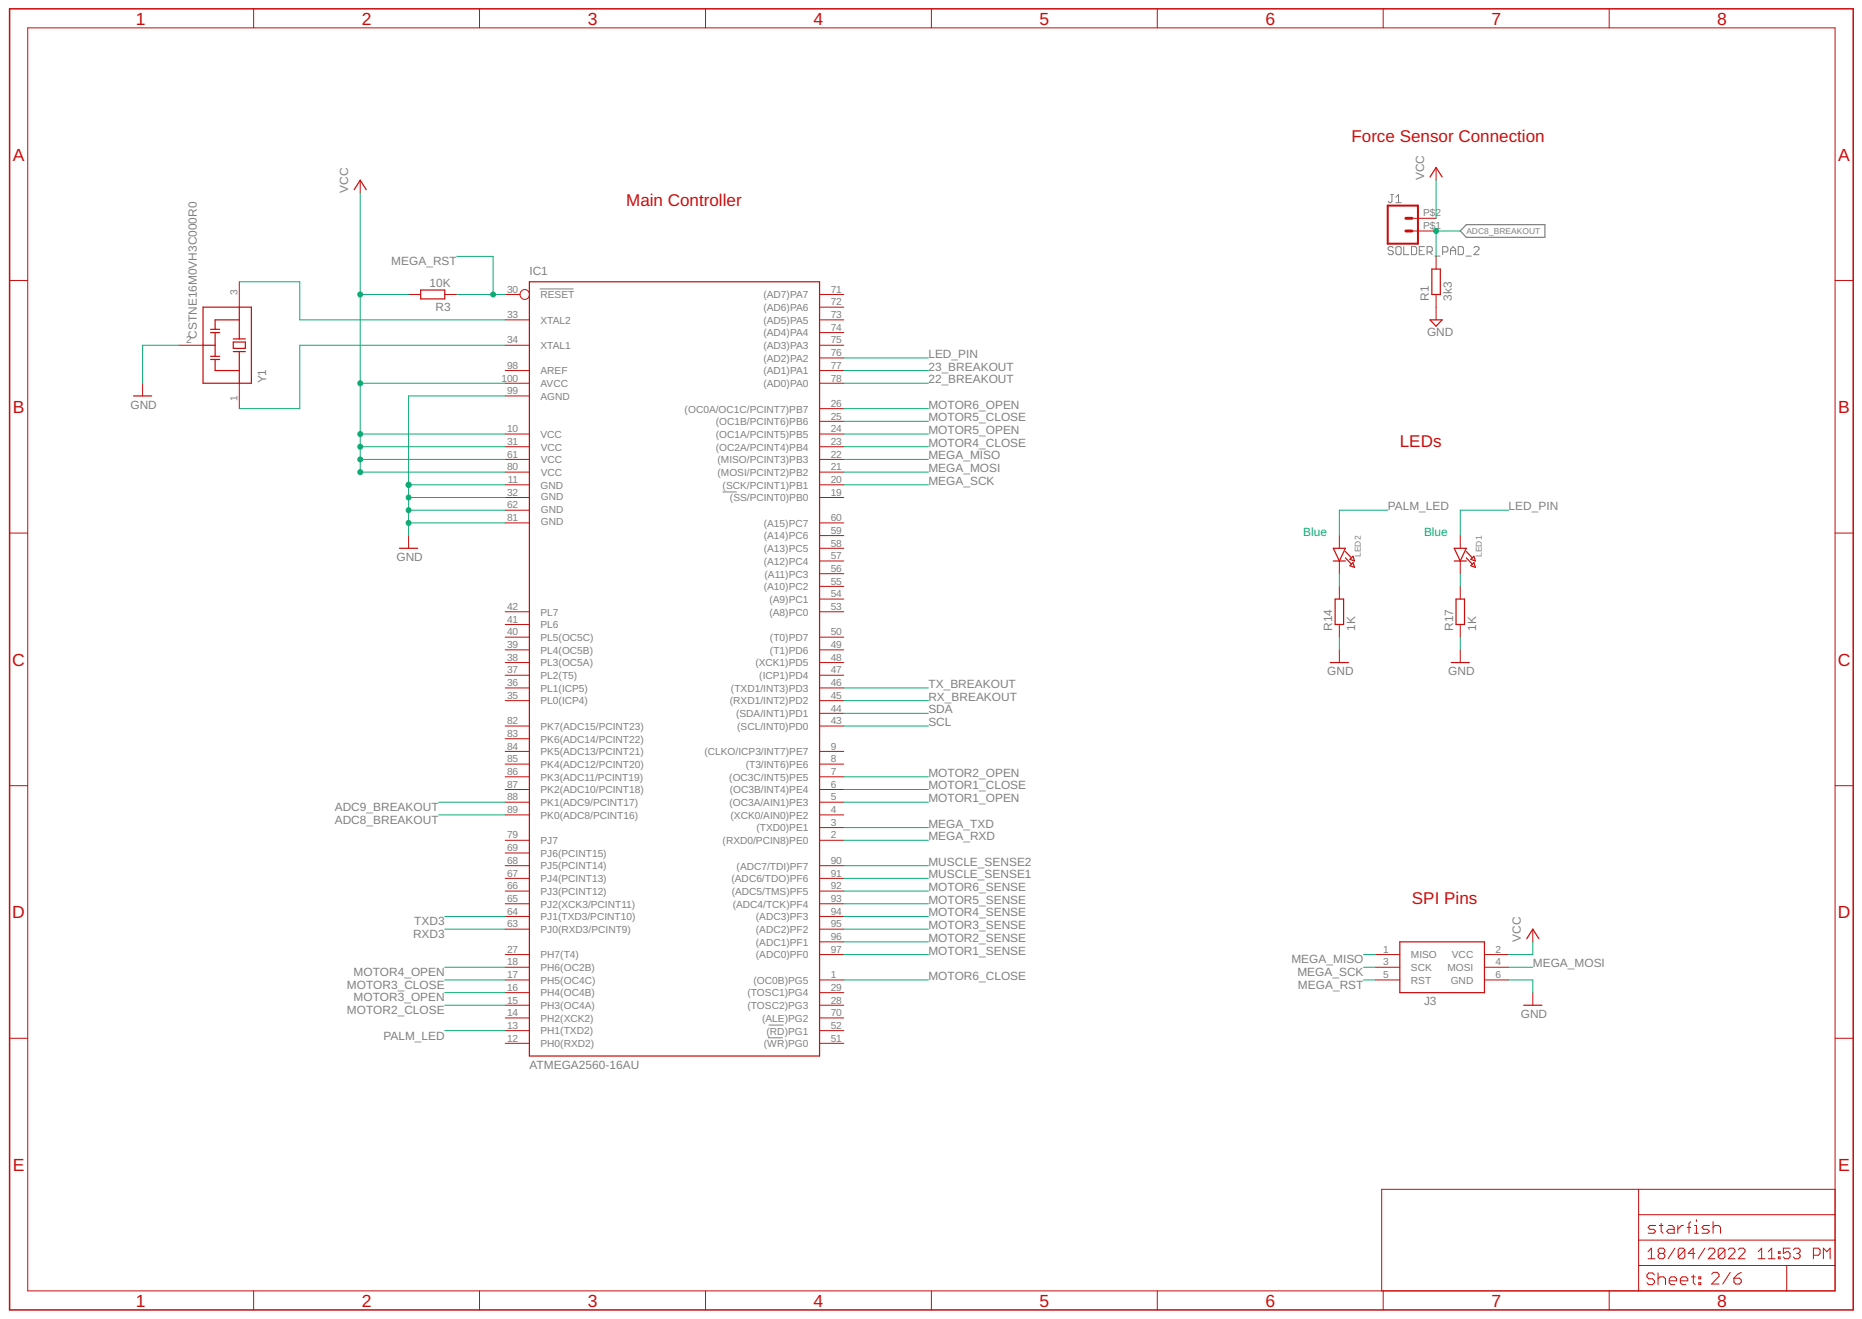
[picture p30: page 2]

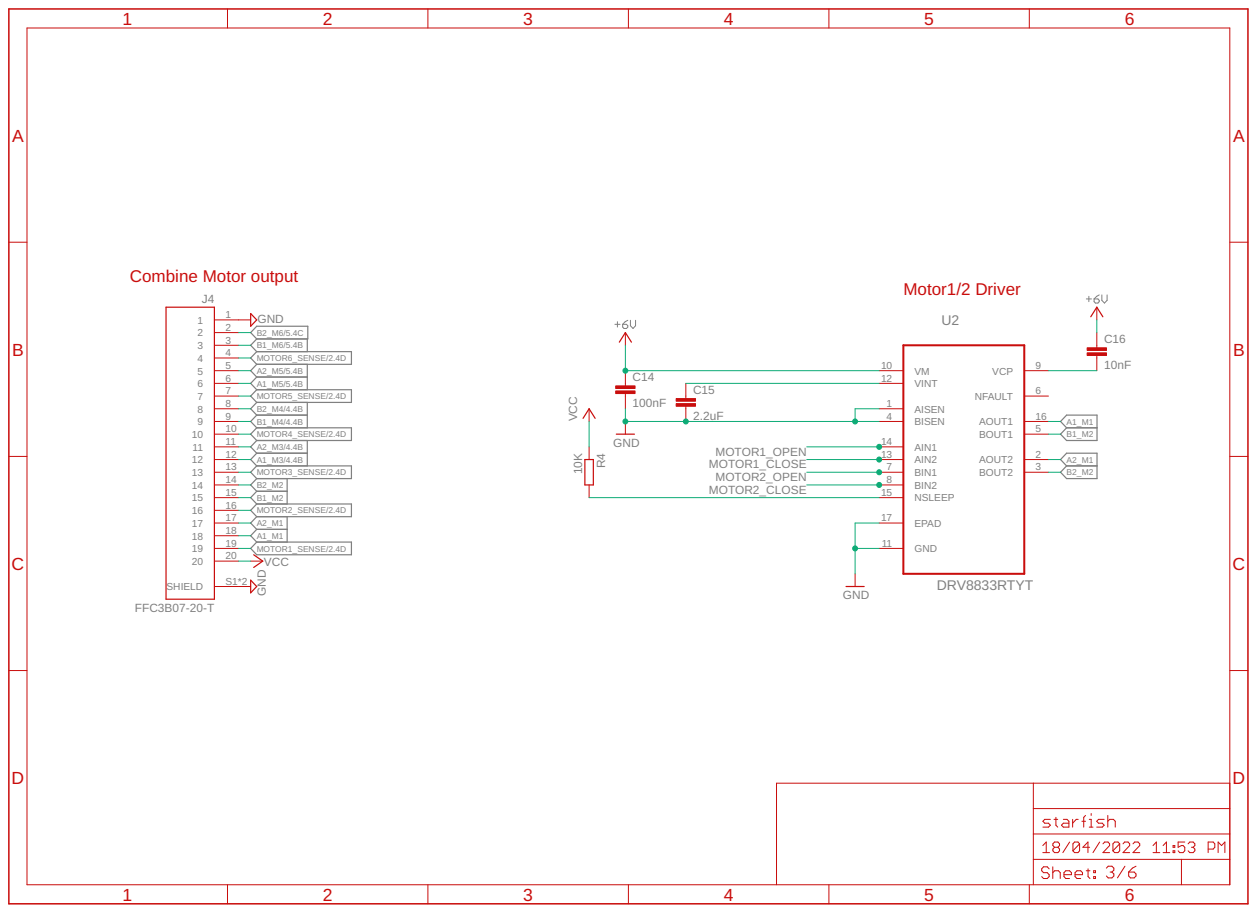
[picture p31: page 3]

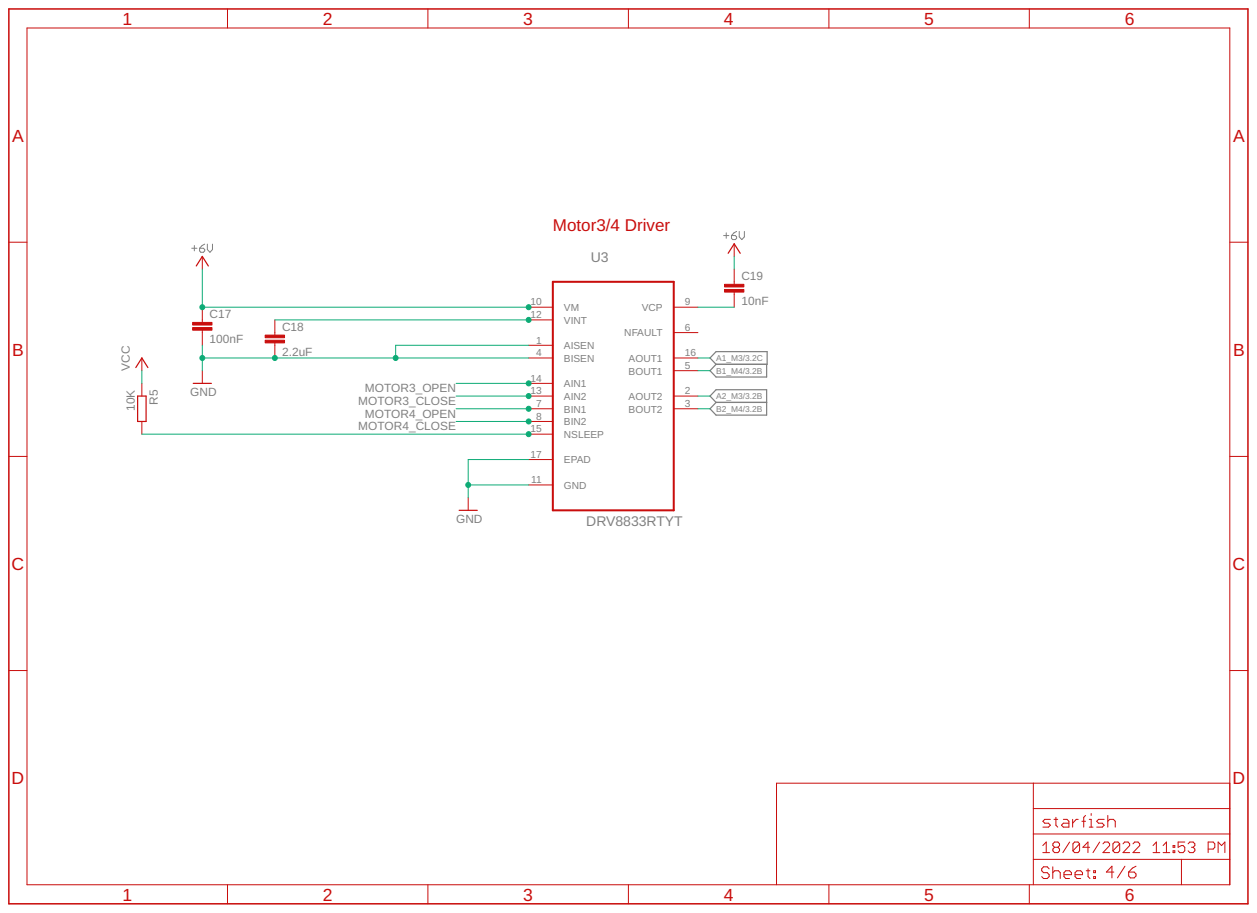
[picture p32: page 4]

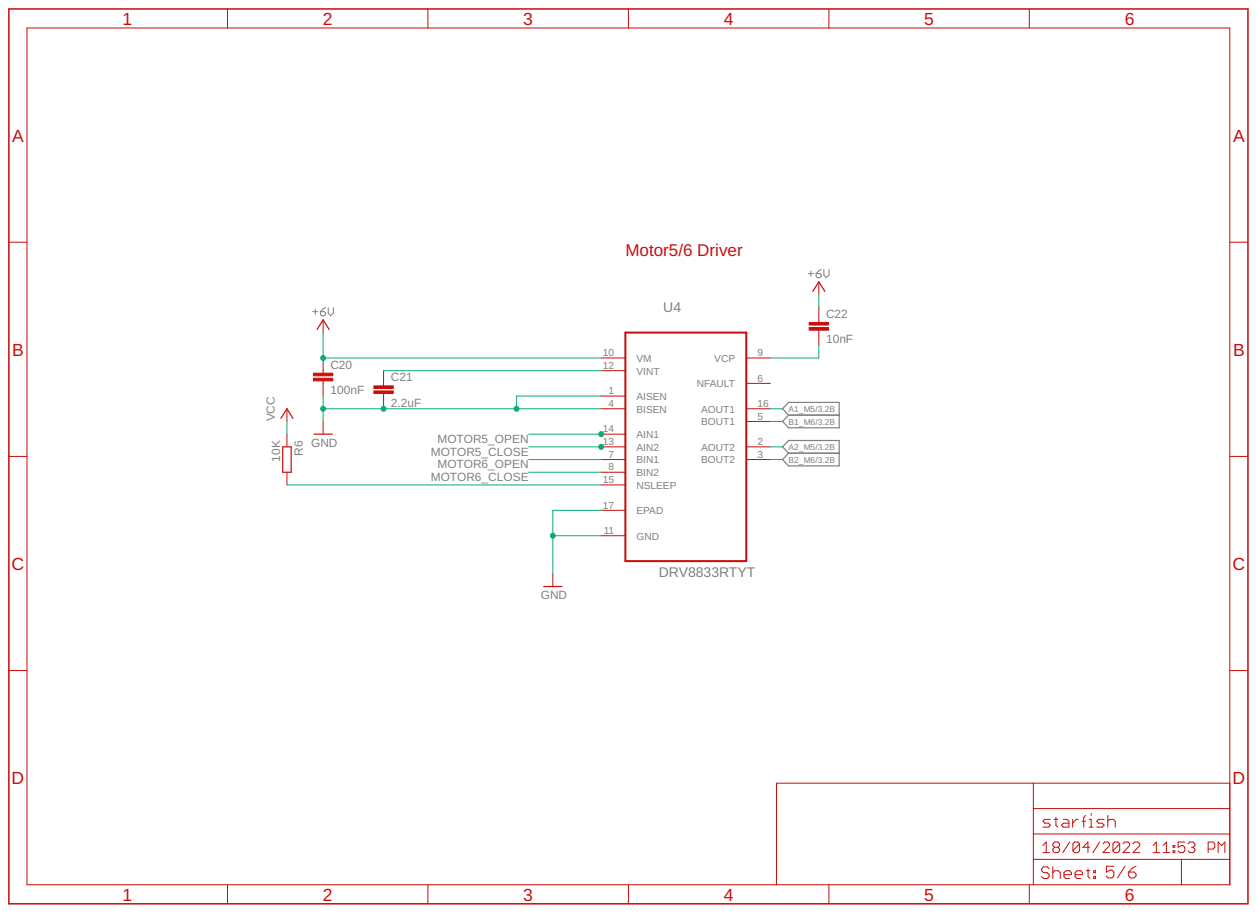
[picture p33: page 5]

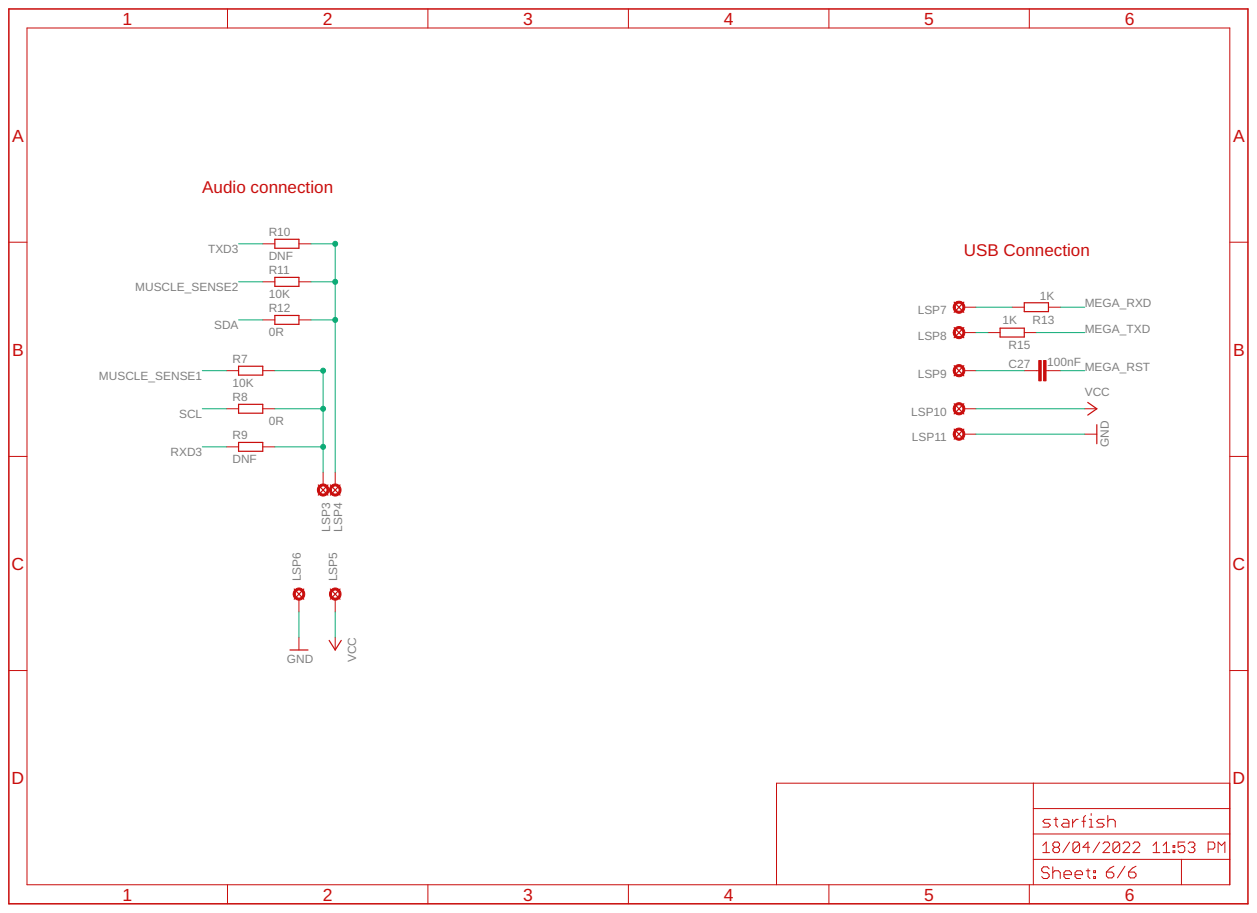
[picture p34: page 6]
