eSpark-Backup/manarharake-palmpcb/docs/Client-Files/palm1/PCB2/PCB files/Motor Connection V1.pdf

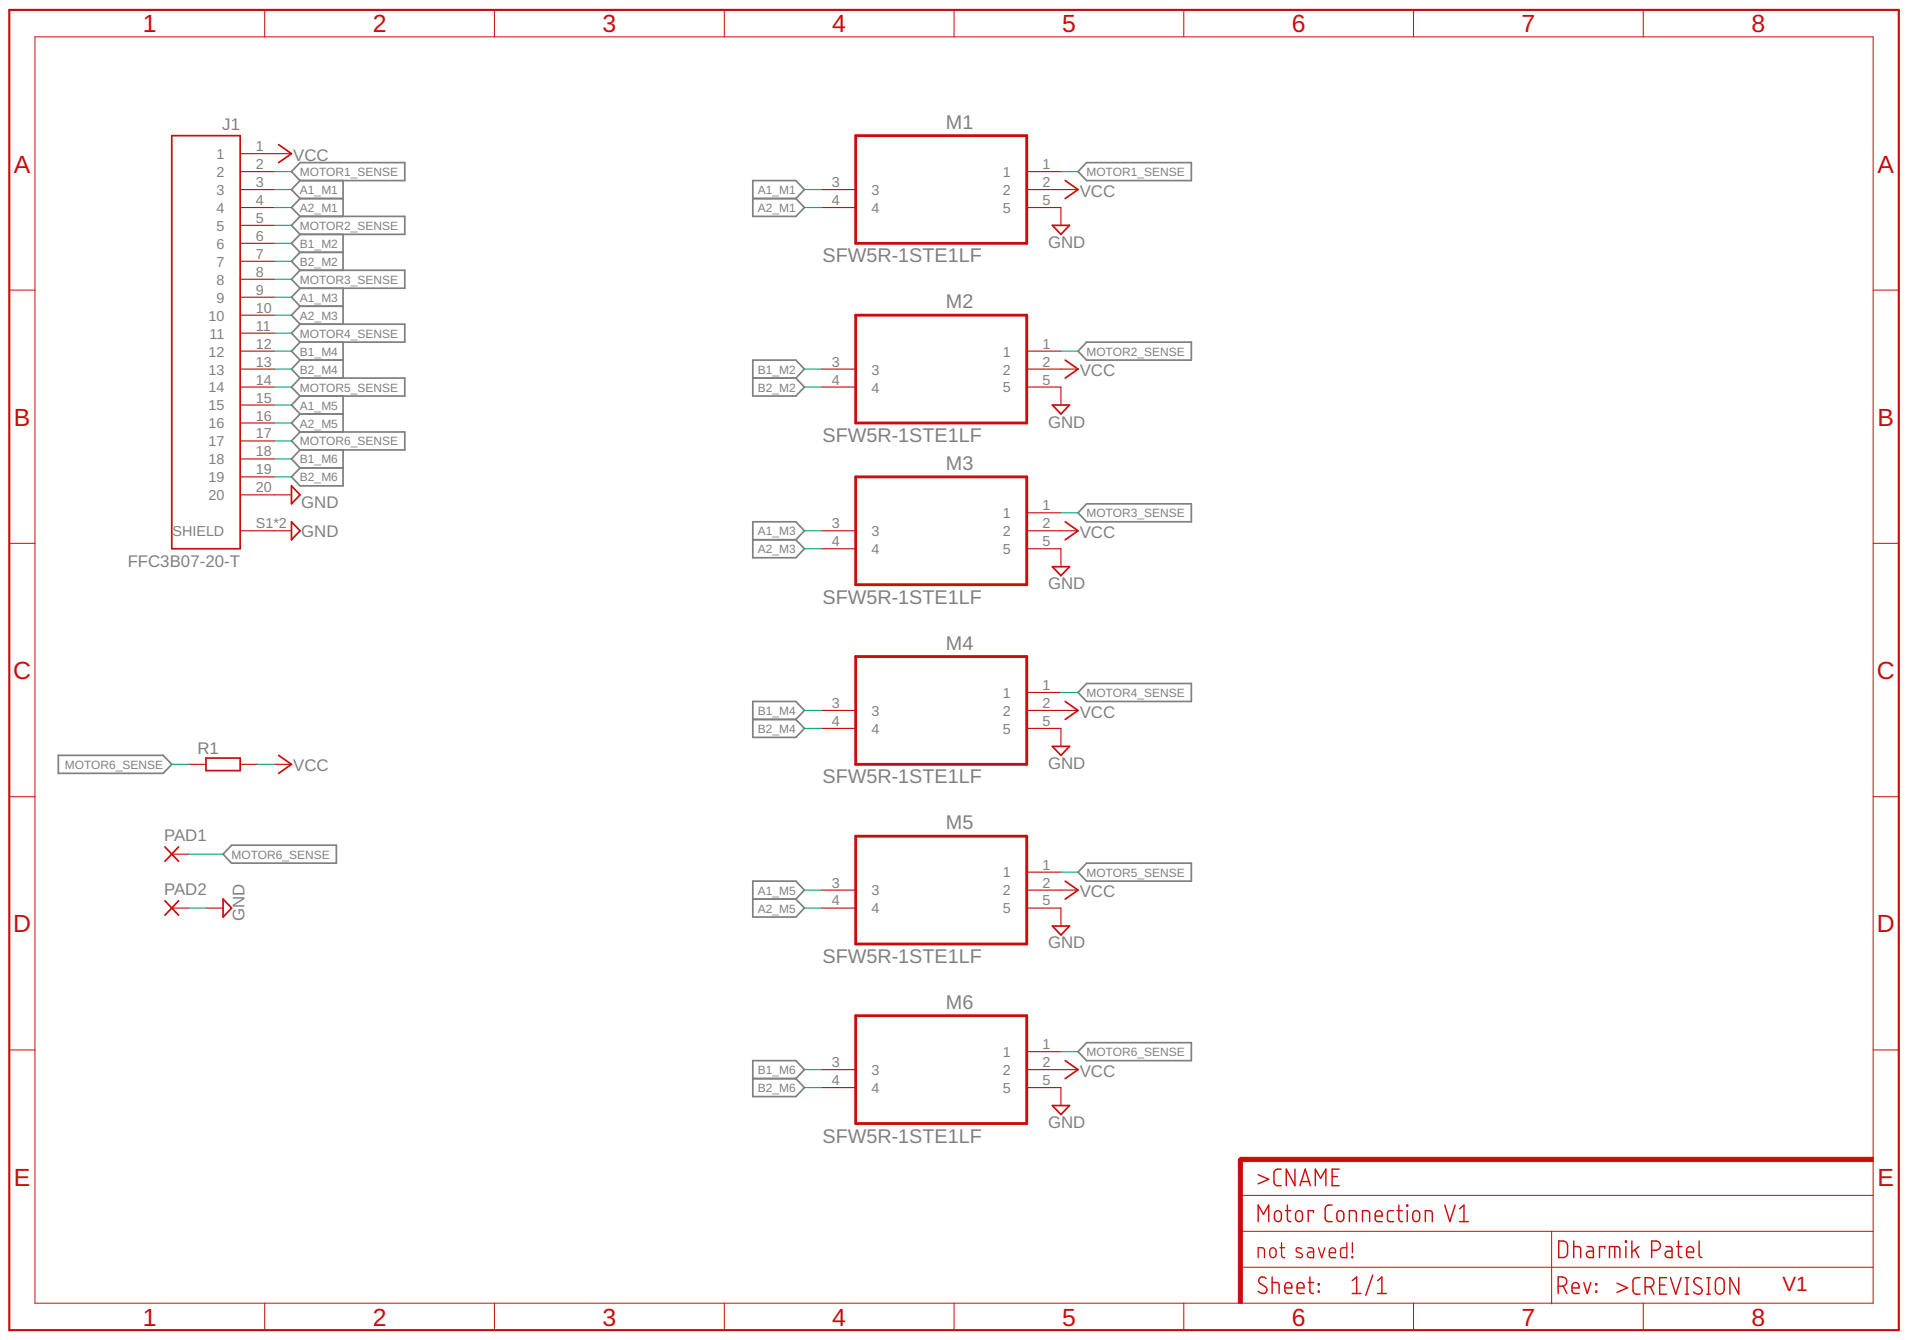
[picture p35: page 1]
