eSpark-Backup/manarharake-palmpcb/(list of files, drawings)

Other design files:
Design_Files/Connector_Sheet.SchDoc
Design_Files/Controller_Sheet.SchDoc
Design_Files/Motor_Connector_Sheet.SchDoc
Design_Files/Motor_Sheet.SchDoc
Design_Files/Palm_V2.0.PrjPcb
Design_Files/PCB_Palm_v2.0.PcbDoc
Design_Files/Power_Sheet.SchDoc
Design_Files/Top_Sheet.SchDoc
Design_Files/USB-to-UART_Sheet.SchDoc
docs/Client-Files/palm1/PCB2/PCB files/Imported (1) Motor Connection V1.PrjPcb/Motor Connection V1.PrjPcb
docs/Client-Files/palm1/PCB2/PCB files/Imported (1) Motor Connection V1.PrjPcb/Motor Connection V1.SchDoc
docs/Client-Files/palm1/PCB2/PCB files/Imported Motor Connection V1.PrjPcb/Motor Connection V1.PcbDoc
docs/Client-Files/palm1/PCB2/PCB files/Imported Motor Connection V1.PrjPcb/Motor Connection V1.PrjPcb
docs/Client-Files/palm1/PCB 1/PCB files/Imported (1) starfish.PrjPcb/starfish.PrjPcb
docs/Client-Files/palm1/PCB 1/PCB files/Imported (1) starfish.PrjPcb/starfish_0.SchDoc
docs/Client-Files/palm1/PCB 1/PCB files/Imported (1) starfish.PrjPcb/starfish_1.SchDoc
docs/Client-Files/palm1/PCB 1/PCB files/Imported (1) starfish.PrjPcb/starfish_2.SchDoc
docs/Client-Files/palm1/PCB 1/PCB files/Imported (1) starfish.PrjPcb/starfish_3.SchDoc
docs/Client-Files/palm1/PCB 1/PCB files/Imported (1) starfish.PrjPcb/starfish_4.SchDoc
docs/Client-Files/palm1/PCB 1/PCB files/Imported (1) starfish.PrjPcb/starfish_5.SchDoc
docs/Client-Files/palm1/PCB 1/PCB files/Imported starfish.PrjPcb/starfish.PcbDoc
docs/Client-Files/palm1/PCB 1/PCB files/Imported starfish.PrjPcb/starfish.PrjPcb
