eSpark-Backup/manarharake-palmpcb/docs/Client-Files/palm1/PCB 1/PCB files/starfish.brd

## EAGLE design docs/Client-Files/palm1/PCB 1/PCB files/starfish.brd (2024-06-12)

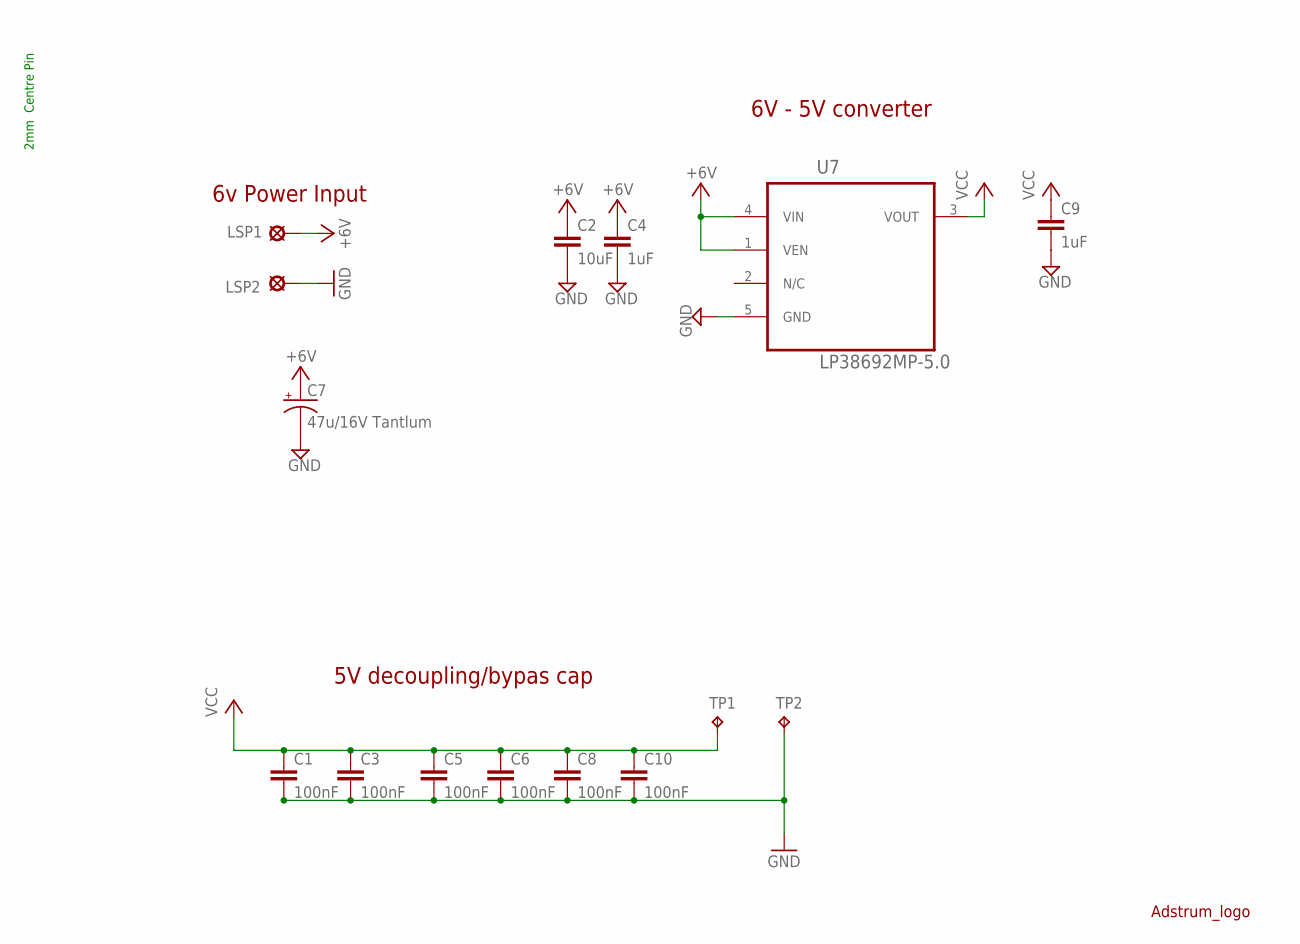
[picture p36: schematic starfish.sch, sheet 1, POWER]

Parts:
C1: 100nF; C1210
C2: 10uF; C0805
C3, C5, C6, C8, C10: 100nF; C0603
C4, C9: 1uF; C0805
C7: 47u/16V Tantlum; C/6032-28R
LSP1, LSP2: LSP10
TP1: vcc; B1,27
TP2: gnd; B1,27
U7: LP38692MP-5.0; SOT150P696X180-5N
U$16: ADSTRUM_LOGO

Connections:
+6V: C2.1, C4.1, C7.+, LSP1.MP, U7.1 (VEN), U7.4 (VIN); also elsewhere on the board
GND: C1.2, C2.2, C3.2, C4.2, C5.2, C6.2, C7.-, C8.2, C9.2, C10.2, LSP2.MP, TP2.TP, U7.5 (GND); also elsewhere on the board
VCC: C1.1, C3.1, C5.1, C6.1, C8.1, C9.1, C10.1, TP1.TP, U7.3 (VOUT); also elsewhere on the board

Notes on the sheet:
2mm Centre Pin
6V - 5V converter
5V decoupling/bypas cap
6v Power Input

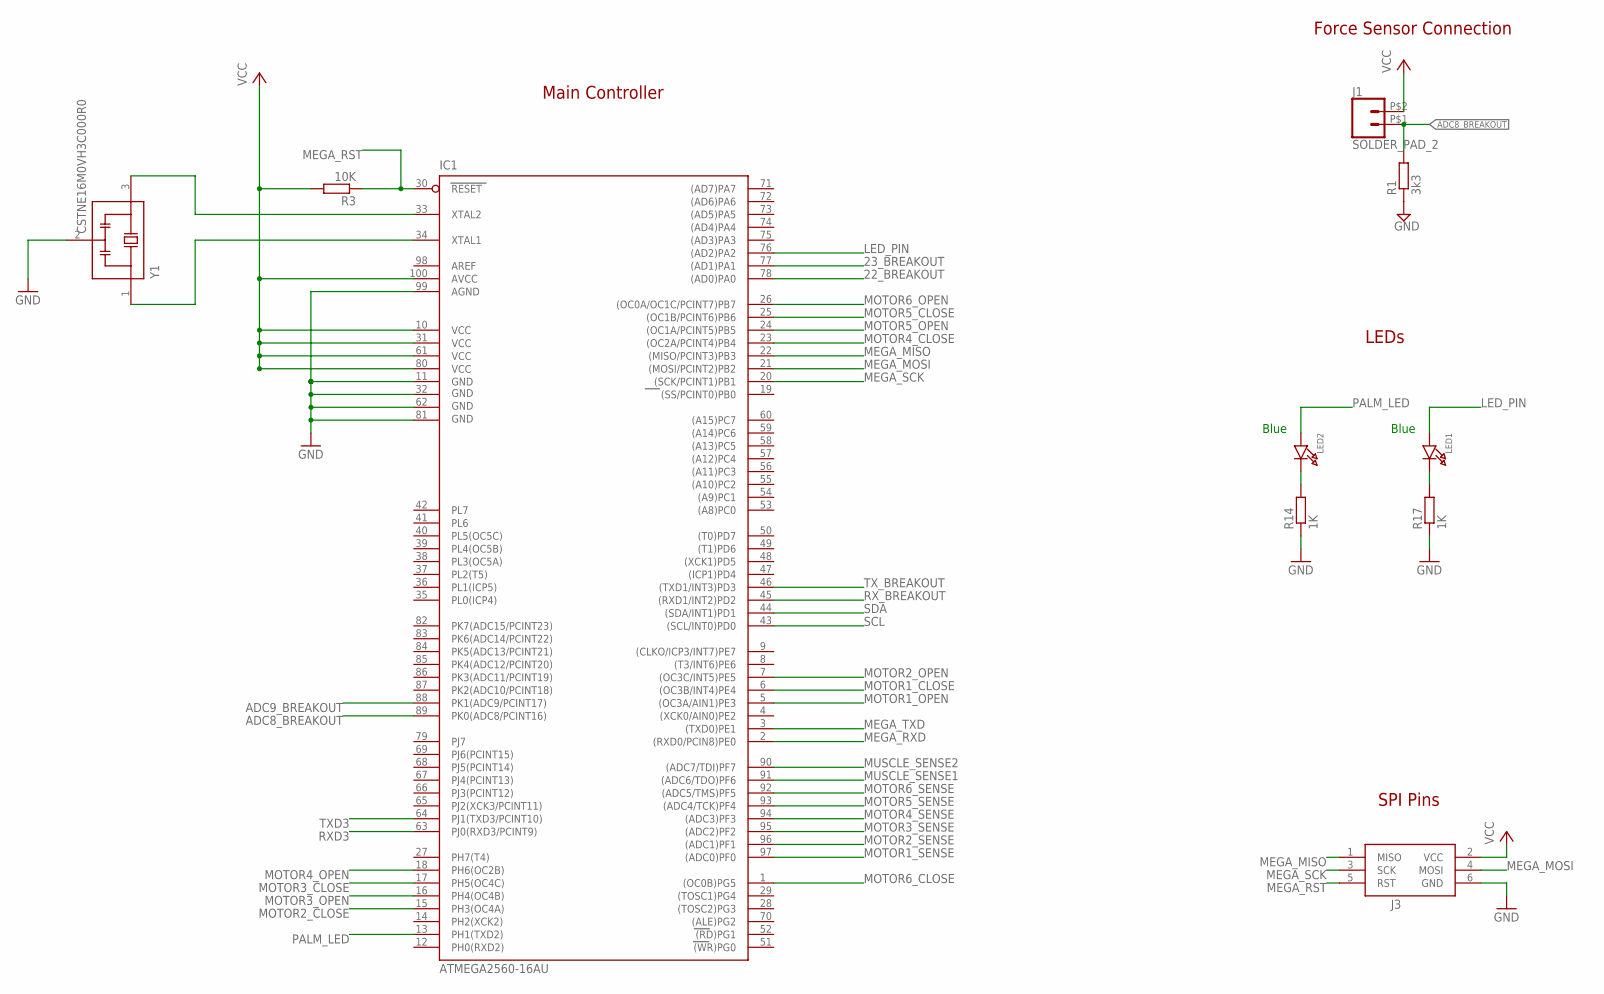
[picture p37: schematic starfish.sch, sheet 2, ATMEGA 2560]

Parts:
IC1: ATMEGA2560-16AU; TQFP100
J1: SOLDER_PAD_2
J3: DNF; AVRISP
LED1, LED2: LED0805; CHIPLED_0805
R1: 3k3; R0603
R3: 10K; R0603
R14, R17: 1K; R0603
Y1: CSTNE16M0VH3C000R0; OSC_CSTNE16M0VH3C000R0

Connections:
22_BREAKOUT: IC1.78 ((AD0)PA0)
23_BREAKOUT: IC1.77 ((AD1)PA1)
ADC8_BREAKOUT: IC1.89 (PK0(ADC8/PCINT16)), J1.P$1 (1), R1.2
ADC9_BREAKOUT: IC1.88 (PK1(ADC9/PCINT17))
GND: IC1.11 (GND), IC1.32 (GND1), IC1.62 (GND2), IC1.81 (GND3), IC1.99 (AGND), J3.6 (GND), R1.1, R14.1, R17.1, Y1.2 (GND); also elsewhere on the board
LED_PIN: IC1.76 ((AD2)PA2), LED1.A
MEGA_MISO: IC1.22 ((MISO/PCINT3)PB3), J3.1 (MISO)
MEGA_MOSI: IC1.21 ((MOSI/PCINT2)PB2), J3.4 (MOSI)
MEGA_RST: IC1.30 (RESET), J3.5 (RST), R3.1; also elsewhere on the board
MEGA_RXD: IC1.2 ((RXD0/PCIN8)PE0); also elsewhere on the board
MEGA_SCK: IC1.20 ((SCK/PCINT1)PB1), J3.3 (SCK)
MEGA_TXD: IC1.3 ((TXD0)PE1); also elsewhere on the board
MOTOR1_CLOSE: IC1.6 ((OC3B/INT4)PE4); also elsewhere on the board
MOTOR1_OPEN: IC1.5 ((OC3A/AIN1)PE3); also elsewhere on the board
MOTOR1_SENSE: IC1.97 ((ADC0)PF0); also elsewhere on the board
MOTOR2_CLOSE: IC1.15 (PH3(OC4A)); also elsewhere on the board
MOTOR2_OPEN: IC1.7 ((OC3C/INT5)PE5); also elsewhere on the board
MOTOR2_SENSE: IC1.96 ((ADC1)PF1); also elsewhere on the board
MOTOR3_CLOSE: IC1.17 (PH5(OC4C)); also elsewhere on the board
MOTOR3_OPEN: IC1.16 (PH4(OC4B)); also elsewhere on the board
MOTOR3_SENSE: IC1.95 ((ADC2)PF2); also elsewhere on the board
MOTOR4_CLOSE: IC1.23 ((OC2A/PCINT4)PB4); also elsewhere on the board
MOTOR4_OPEN: IC1.18 (PH6(OC2B)); also elsewhere on the board
MOTOR4_SENSE: IC1.94 ((ADC3)PF3); also elsewhere on the board
MOTOR5_CLOSE: IC1.25 ((OC1B/PCINT6)PB6); also elsewhere on the board
MOTOR5_OPEN: IC1.24 ((OC1A/PCINT5)PB5); also elsewhere on the board
MOTOR5_SENSE: IC1.93 ((ADC4/TCK)PF4); also elsewhere on the board
MOTOR6_CLOSE: IC1.1 ((OC0B)PG5); also elsewhere on the board
MOTOR6_OPEN: IC1.26 ((OC0A/OC1C/PCINT7)PB7); also elsewhere on the board
MOTOR6_SENSE: IC1.92 ((ADC5/TMS)PF5); also elsewhere on the board
MUSCLE_SENSE1: IC1.91 ((ADC6/TDO)PF6); also elsewhere on the board
MUSCLE_SENSE2: IC1.90 ((ADC7/TDI)PF7); also elsewhere on the board
unnamed: LED1.C, R17.2
unnamed: IC1.34 (XTAL1), Y1.1 (IN)
unnamed: LED2.C, R14.2
unnamed: IC1.33 (XTAL2), Y1.3 (OUT)
PALM_LED: IC1.13 (PH1(TXD2)), LED2.A
RXD3: IC1.63 (PJ0(RXD3/PCINT9)); also elsewhere on the board
RX_BREAKOUT: IC1.45 ((RXD1/INT2)PD2)
SCL: IC1.43 ((SCL/INT0)PD0); also elsewhere on the board
SDA: IC1.44 ((SDA/INT1)PD1); also elsewhere on the board
TXD3: IC1.64 (PJ1(TXD3/PCINT10)); also elsewhere on the board
TX_BREAKOUT: IC1.46 ((TXD1/INT3)PD3)
VCC: IC1.10 (VCC), IC1.31 (VCC1), IC1.61 (VCC2), IC1.80 (VCC3), IC1.100 (AVCC), J1.P$2 (2), J3.2 (VCC), R3.2; also elsewhere on the board

Notes on the sheet:
Blue
Force Sensor Connection
SPI Pins
LEDs
Main Controller

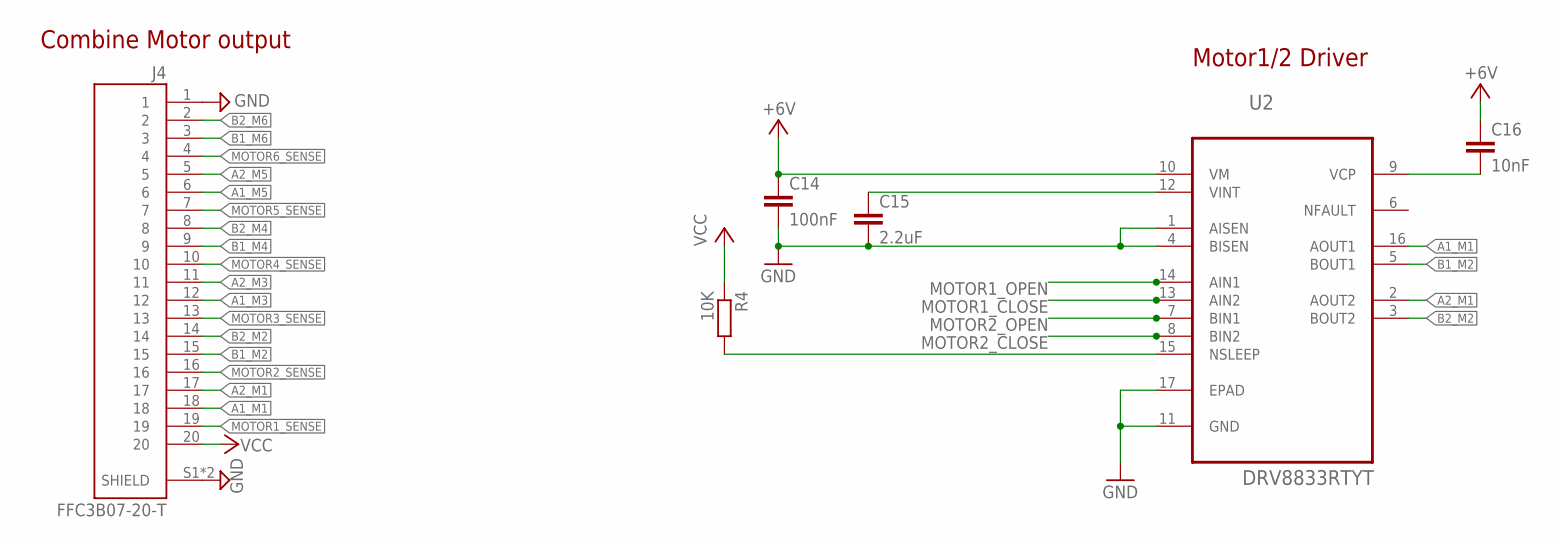
[picture p38: schematic starfish.sch, sheet 3, MOTOR 1&2]

Parts:
C14: 100nF; C0603
C15: 2.2uF; C0603
C16: 10nF; C0603
J4: FFC3B07-20-T; GCT_FFC3B07-20-T
R4: 10K; R0603
U2: DRV8833RTYT; QFN65P400X400X80-17N

Connections:
+6V: C14.1, C16.1, U2.10 (VM); also elsewhere on the board
A1_M1: J4.18, U2.16 (AOUT1)
A1_M3: J4.12; also elsewhere on the board
A1_M5: J4.6; also elsewhere on the board
A2_M1: J4.17, U2.2 (AOUT2)
A2_M3: J4.11; also elsewhere on the board
A2_M5: J4.5; also elsewhere on the board
B1_M2: J4.15, U2.5 (BOUT1)
B1_M4: J4.9; also elsewhere on the board
B1_M6: J4.3; also elsewhere on the board
B2_M2: J4.14, U2.3 (BOUT2)
B2_M4: J4.8; also elsewhere on the board
B2_M6: J4.2; also elsewhere on the board
GND: C14.2, C15.2, J4.1, J4.S1 (SHIELD), J4.S2 (SHIELD), U2.1 (AISEN), U2.4 (BISEN), U2.11 (GND), U2.17 (EPAD); also elsewhere on the board
MOTOR1_CLOSE: U2.13 (AIN2); also elsewhere on the board
MOTOR1_OPEN: U2.14 (AIN1); also elsewhere on the board
MOTOR1_SENSE: J4.19; also elsewhere on the board
MOTOR2_CLOSE: U2.8 (BIN2); also elsewhere on the board
MOTOR2_OPEN: U2.7 (BIN1); also elsewhere on the board
MOTOR2_SENSE: J4.16; also elsewhere on the board
MOTOR3_SENSE: J4.13; also elsewhere on the board
MOTOR4_SENSE: J4.10; also elsewhere on the board
MOTOR5_SENSE: J4.7; also elsewhere on the board
MOTOR6_SENSE: J4.4; also elsewhere on the board
unnamed: C16.2, U2.9 (VCP)
unnamed: R4.2, U2.15 (NSLEEP)
unnamed: C15.1, U2.12 (VINT)
VCC: J4.20, R4.1; also elsewhere on the board

Notes on the sheet:
Combine Motor output
Motor1/2 Driver

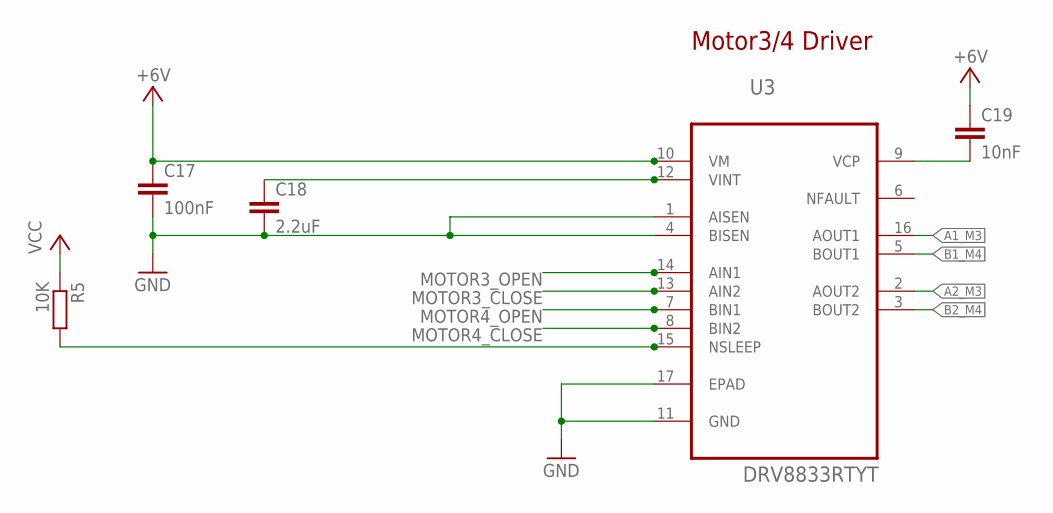
[picture p39: schematic starfish.sch, sheet 4, MOTOR 3&4]

Parts:
C17: 100nF; C0603
C18: 2.2uF; C0603
C19: 10nF; C0603
R5: 10K; R0603
U3: DRV8833RTYT; QFN65P400X400X80-17N

Connections:
+6V: C17.1, C19.1, U3.10 (VM); also elsewhere on the board
A1_M3: U3.16 (AOUT1); also elsewhere on the board
A2_M3: U3.2 (AOUT2); also elsewhere on the board
B1_M4: U3.5 (BOUT1); also elsewhere on the board
B2_M4: U3.3 (BOUT2); also elsewhere on the board
GND: C17.2, C18.2, U3.1 (AISEN), U3.4 (BISEN), U3.11 (GND), U3.17 (EPAD); also elsewhere on the board
MOTOR3_CLOSE: U3.13 (AIN2); also elsewhere on the board
MOTOR3_OPEN: U3.14 (AIN1); also elsewhere on the board
MOTOR4_CLOSE: U3.8 (BIN2); also elsewhere on the board
MOTOR4_OPEN: U3.7 (BIN1); also elsewhere on the board
unnamed: C19.2, U3.9 (VCP)
unnamed: C18.1, U3.12 (VINT)
unnamed: R5.2, U3.15 (NSLEEP)
VCC: R5.1; also elsewhere on the board

Notes on the sheet:
Motor3/4 Driver

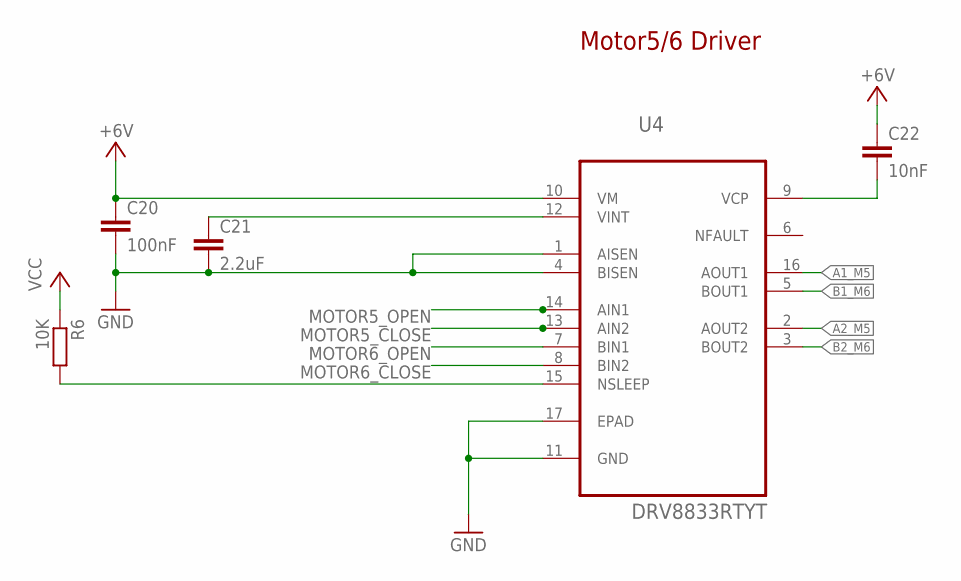
[picture p40: schematic starfish.sch, sheet 5, MOTOR 5 & SERVO]

Parts:
C20: 100nF; C0603
C21: 2.2uF; C0603
C22: 10nF; C0603
R6: 10K; R0603
U4: DRV8833RTYT; QFN65P400X400X80-17N

Connections:
+6V: C20.1, C22.1, U4.10 (VM); also elsewhere on the board
A1_M5: U4.16 (AOUT1); also elsewhere on the board
A2_M5: U4.2 (AOUT2); also elsewhere on the board
B1_M6: U4.5 (BOUT1); also elsewhere on the board
B2_M6: U4.3 (BOUT2); also elsewhere on the board
GND: C20.2, C21.2, U4.1 (AISEN), U4.4 (BISEN), U4.11 (GND), U4.17 (EPAD); also elsewhere on the board
MOTOR5_CLOSE: U4.13 (AIN2); also elsewhere on the board
MOTOR5_OPEN: U4.14 (AIN1); also elsewhere on the board
MOTOR6_CLOSE: U4.8 (BIN2); also elsewhere on the board
MOTOR6_OPEN: U4.7 (BIN1); also elsewhere on the board
unnamed: C21.1, U4.12 (VINT)
unnamed: C22.2, U4.9 (VCP)
unnamed: R6.2, U4.15 (NSLEEP)
VCC: R6.1; also elsewhere on the board

Notes on the sheet:
Motor5/6 Driver

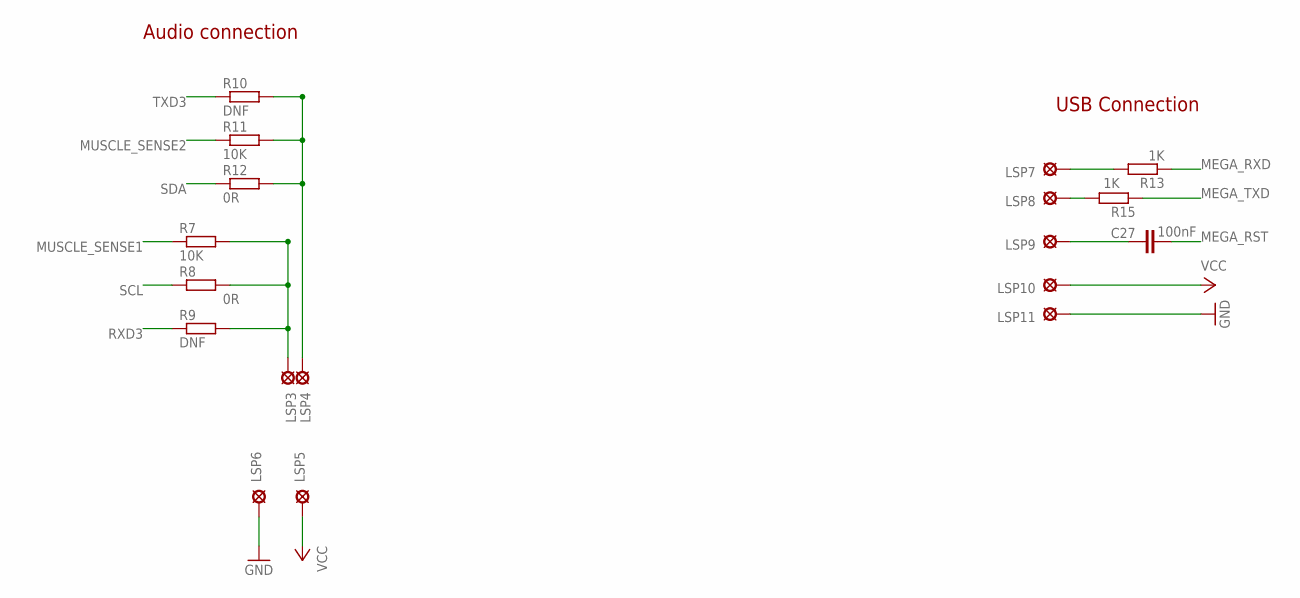
[picture p41: schematic starfish.sch, sheet 6, COMMS]

Parts:
C27: 100nF; C0603
LSP3, LSP4, LSP5, LSP6, LSP7, LSP8, LSP9, LSP10, LSP11: LSP10
R7, R11: 10K; R0603
R8, R12: 0R; R0603
R9, R10: DNF; R0603
R13, R15: 1K; R0603

Connections:
GND: LSP6.MP, LSP11.MP; also elsewhere on the board
MEGA_RST: C27.2; also elsewhere on the board
MEGA_RXD: R13.1; also elsewhere on the board
MEGA_TXD: R15.1; also elsewhere on the board
MUSCLE_SENSE1: R7.1; also elsewhere on the board
MUSCLE_SENSE2: R11.1; also elsewhere on the board
unnamed: LSP4.MP, R10.2, R11.2, R12.2
unnamed: C27.1, LSP9.MP
unnamed: LSP3.MP, R7.2, R8.2, R9.2
unnamed: LSP7.MP, R13.2
unnamed: LSP8.MP, R15.2
RXD3: R9.1; also elsewhere on the board
SCL: R8.1; also elsewhere on the board
SDA: R12.1; also elsewhere on the board
TXD3: R10.1; also elsewhere on the board
VCC: LSP5.MP, LSP10.MP; also elsewhere on the board

Notes on the sheet:
Audio connection
USB Connection

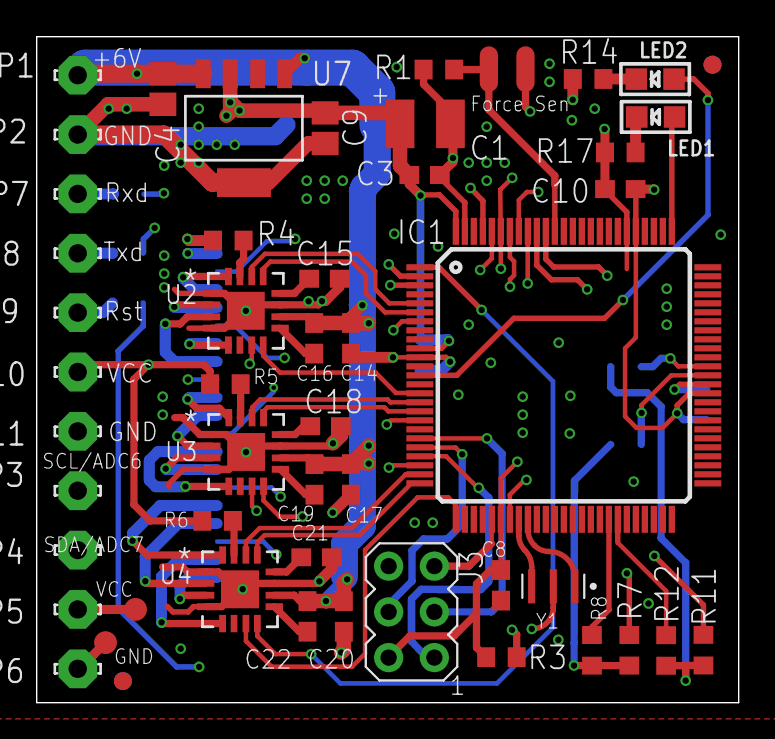
[picture p42: board starfish.brd from above]

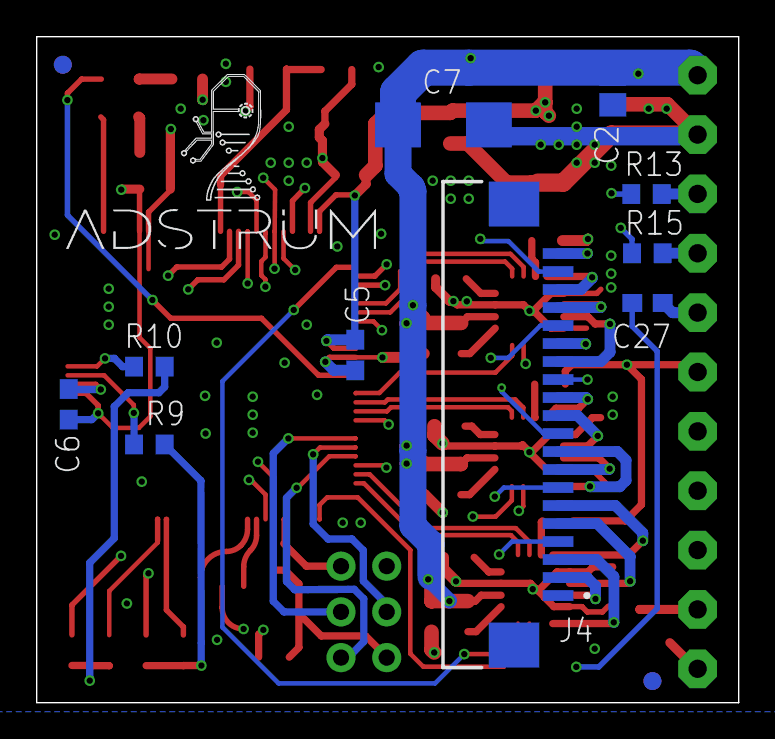
[picture p43: board starfish.brd from below]

Board: 4 copper layers, 39.0 x 37.0 mm, 62 parts (11 on the bottom side), 66 nets.

Other parts of the board:
U$1, U$17: CIRCLE-1MM-2R
