eSpark-Backup/manarharake-palmpcb/docs/Client-Files/palm1/PCB2/PCB files/Motor Connection V1.brd

## EAGLE design docs/Client-Files/palm1/PCB2/PCB files/Motor Connection V1.brd (2024-06-12)

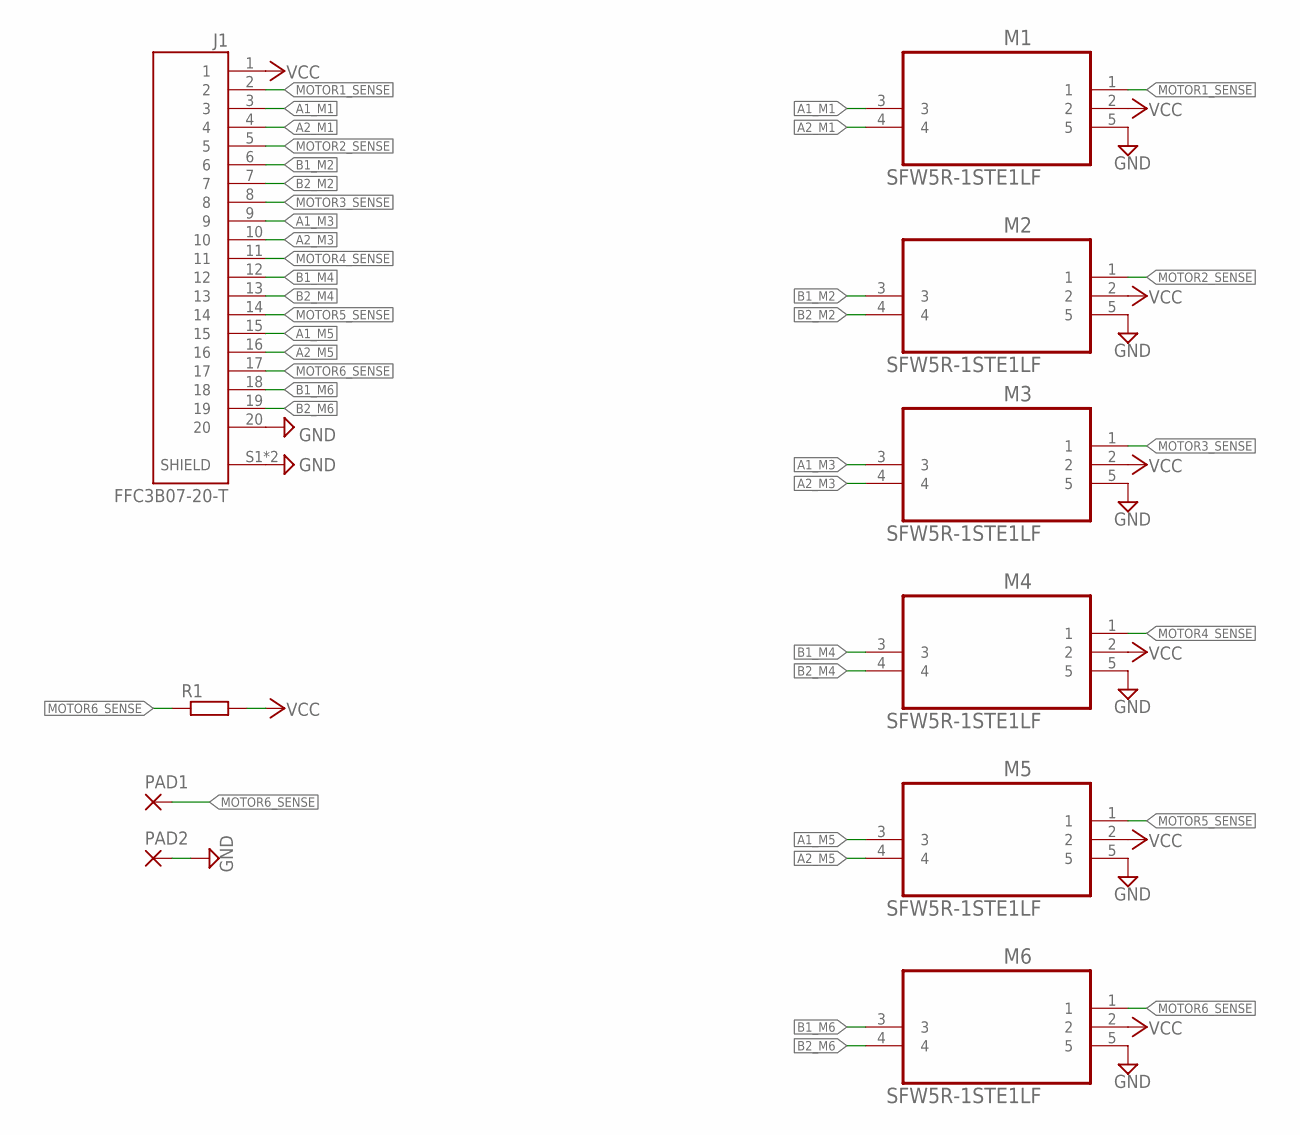
[picture p44: schematic Motor Connection V1.sch]

Parts:
J1: FFC3B07-20-T; GCT_FFC3B07-20-T
M1, M2, M3, M4, M5, M6: SFW5R-1STE1LF; FCI_SFW5R-1STE1LF
PAD1, PAD2: SMD2; SMD1,27-2,54
R1: R-EU_R0603; R0603

Connections:
A1_M1: J1.3, M1.3
A1_M3: J1.9, M3.3
A1_M5: J1.15, M5.3
A2_M1: J1.4, M1.4
A2_M3: J1.10, M3.4
A2_M5: J1.16, M5.4
B1_M2: J1.6, M2.3
B1_M4: J1.12, M4.3
B1_M6: J1.18, M6.3
B2_M2: J1.7, M2.4
B2_M4: J1.13, M4.4
B2_M6: J1.19, M6.4
GND: J1.20, J1.S1 (SHIELD), J1.S2 (SHIELD), M1.5, M2.5, M3.5, M4.5, M5.5, M6.5, PAD2.1
MOTOR1_SENSE: J1.2, M1.1
MOTOR2_SENSE: J1.5, M2.1
MOTOR3_SENSE: J1.8, M3.1
MOTOR4_SENSE: J1.11, M4.1
MOTOR5_SENSE: J1.14, M5.1
MOTOR6_SENSE: J1.17, M6.1, PAD1.1, R1.1
VCC: J1.1, M1.2, M2.2, M3.2, M4.2, M5.2, M6.2, R1.2

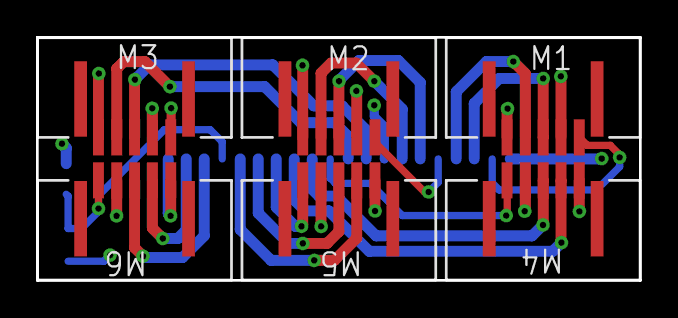
[picture p45: board Motor Connection V1.brd from above]

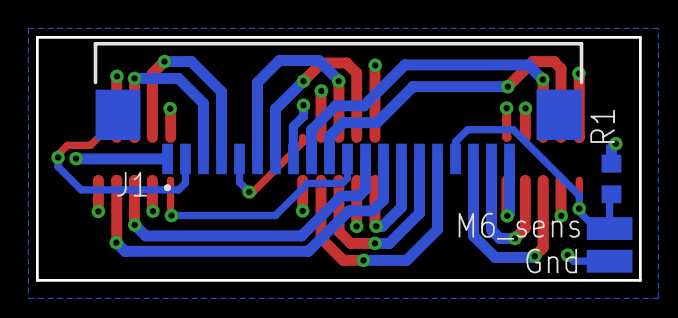
[picture p46: board Motor Connection V1.brd from below]

Board: 4 copper layers, 33.5 x 13.5 mm, 10 parts (4 on the bottom side), 20 nets.
