eSpark-Backup/manarharake-palmpcb/(commit log)

2024-06-12 step file uploaded
    [PCB Layout With Mounting Screws.stl]
2024-06-12 #1 In-progress.
    [BOM.xlsx, Centroid.xlsx, Connector_Sheet.SchDoc, Controller_Sheet.SchDoc, Motor Connection V1.PcbDoc, Motor Connection V1.PrjPcb, Motor Connection V1.SchDoc, Motor Connection V1.brd]
2024-06-13 #1 Schematic In-progress:
    [Connector_Sheet.SchDoc, Controller_Sheet.SchDoc, Motor Connection V1.PcbDoc, Motor_Connector_Sheet.SchDoc, Motor_Sheet.SchDoc, PCB_Palm_v2.0.PcbDoc, Palm_V2.0.PrjPcb, Power_Sheet.SchDoc]
2024-06-13 #1 Schematic Completed: Parts placement in-progress.
    [Connector_Sheet.SchDoc, Controller_Sheet.SchDoc, Motor_Connector_Sheet.SchDoc, Motor_Sheet.SchDoc, PCB_Palm_v2.0.PcbDoc, Palm_V2.0.PrjPcb, Power_Sheet.SchDoc, Top_Sheet.SchDoc]
2024-06-14 #1 Schematic completed: PDF Generated: Client BOM Generated.
    [Connector_Sheet.SchDoc, Controller_Sheet.SchDoc, Motor_Connector_Sheet.SchDoc, Motor_Sheet.SchDoc, PCB_Palm_v2.0.PcbDoc, Palm_V2.0.PrjPcb, Power_Sheet.SchDoc, Top_Sheet.SchDoc]
2024-06-14 #1 Updated PDF.
    [Controller_Sheet.SchDoc, Palm_V2.0.PrjPcb]
2024-06-14 #1 Parts updated in Schematic: Fresh BOM generated.
    [Connector_Sheet.SchDoc, Controller_Sheet.SchDoc, Motor_Sheet.SchDoc, PCB_Palm_v2.0.PcbDoc, Palm_V2.0.PrjPcb, USB-to-UART_Sheet.SchDoc]
2024-06-14 #1 JLCPCB and Client BOM generated.
    [Client_BOM.xlsx, JLCPCB_BOM.xlsx]
2024-06-14 #1 Parts placement in-progress.
    [Client_BOM.xlsx, Connector_Sheet.SchDoc, Controller_Sheet.SchDoc, JLCPCB_BOM.xlsx, Motor_Connector_Sheet.SchDoc, Motor_Sheet.SchDoc, PCB_Palm_v2.0.PcbDoc, Palm_V2.0.PrjPcb]
2024-06-15 #1 PCB designing in-progress.
    [Connector_Sheet.SchDoc, Controller_Sheet.SchDoc, Motor_Connector_Sheet.SchDoc, Motor_Sheet.SchDoc, PCB_Palm_v2.0.PcbDoc, Palm_V2.0.PrjPcb, Power_Sheet.SchDoc, Top_Sheet.SchDoc]
2024-06-15 #1 Routing In-progress
    [Client_BOM.xlsx, Connector_Sheet.SchDoc, Controller_Sheet.SchDoc, JLCPCB_BOM.xlsx, Motor_Connector_Sheet.SchDoc, Motor_Sheet.SchDoc, PCB_Palm_v2.0.PcbDoc, PCB_Palm_v2.0_New.PcbDoc]
2024-06-16 #1 Routing in-progress.
    [Connector_Sheet.SchDoc, Controller_Sheet.SchDoc, Motor_Connector_Sheet.SchDoc, Motor_Sheet.SchDoc, PCB_Palm_v2.0.PcbDoc, Palm_V2.0.PrjPcb, Power_Sheet.SchDoc, Top_Sheet.SchDoc]
2024-06-16 #1 Footprint updated: Routing In-progress:
    [Motor_Connector_Sheet.SchDoc, PCB_Palm_v2.0.PcbDoc]
2024-06-18 #1 BOM's updated with FPC Part No. : Re-routing in-progress.
    [Client_BOM.xlsx, Connector_Sheet.SchDoc, Controller_Sheet.SchDoc, JLCPCB_BOM.xlsx, Motor_Connector_Sheet.SchDoc, Motor_Sheet.SchDoc, PCB_Palm_New_v2.0.PcbDoc, PCB_Palm_v2.0.PcbDoc]
2024-06-18 #1 Re-routing in-progress.
    [PCB_Palm_New_v2.0.PcbDoc]
2024-06-19 #1 Done: Fresh Deliverables generated: BOM Updated with changes.
    [Centroid_File-Palm_v2.0.csv, Connector_Sheet.SchDoc, Controller_Sheet.SchDoc, Motor_Connector_Sheet.SchDoc, Motor_Sheet.SchDoc, PCB_Palm_New_v2.0.PcbDoc, PCB_Palm_v2.0.DWG, PCB_Palm_v2.0.DXF]
2024-06-20 #1 @MarsVirgo Client and JLCPCB BOM Updated.
    [Client_BOM.xlsx, JLCPCB_BOM.xlsx]
2024-06-20 pcb reference dxf and step files added
    [PCB Layout Bottom.DXF, PCB Layout Top.DXF, PCB Layout With Mounting Screws.stl, starfish-PCB1.stp]
2024-06-20 #1 Changes in Schematic done: Changes in PCB In-progress.
    [Centroid_File-Palm_v2.0.csv, Connector_Sheet.SchDoc, Controller_Sheet.SchDoc, Motor_Connector_Sheet.SchDoc, Motor_Sheet.SchDoc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]
2024-06-20 #1 Connector update in Client and JLCPCB BOM.
    [Client_BOM.xlsx, JLCPCB_BOM.xlsx]
2024-06-20 #1 PCB Size Reduced: Routing In-progress.
    [PCB_Palm_v2.0.DWG, PCB_Palm_v2.0.DWG.DWG, PCB_Palm_v2.0.DXF, PCB_Palm_v2.0.PcbDoc, PCB_Palm_v2.0.step, Palm_V2.0.PrjPcb]
2024-06-21 #1 Fresh PDF Generated.
    [Connector_Sheet.SchDoc, Controller_Sheet.SchDoc, Motor_Connector_Sheet.SchDoc, Motor_Sheet.SchDoc, PCB_Palm_v2.0.PcbDoc, Palm_V2.0.PrjPcb, Power_Sheet.SchDoc, Top_Sheet.SchDoc]
2024-06-21 #1 PCB Completed: Fresh Deliverables generated.
    [Centroid_File_Palm_v2.0.csv, Client_BOM.xlsx, Connector_Sheet.SchDoc, Controller_Sheet.SchDoc, JLCPCB_BOM.xlsx, Motor_Connector_Sheet.SchDoc, Motor_Sheet.SchDoc, PCB_Palm_v2.0.DWG]
2024-06-26 #1 Updated Gerber Files.
    [PCB_Palm_v2.0.GBL, PCB_Palm_v2.0.GBO, PCB_Palm_v2.0.GBP, PCB_Palm_v2.0.GBS, PCB_Palm_v2.0.GKO, PCB_Palm_v2.0.GTL, PCB_Palm_v2.0.GTO, PCB_Palm_v2.0.GTP]
2024-06-26 #1 Updated Gerber and Pick n Place files.
    [PCB_Palm_v2.0.GBL, PCB_Palm_v2.0.GBO, PCB_Palm_v2.0.GBP, PCB_Palm_v2.0.GBS, PCB_Palm_v2.0.GKO, PCB_Palm_v2.0.GTL, PCB_Palm_v2.0.GTO, PCB_Palm_v2.0.GTP]
